hanafi9/sb1-9dzehn3x/README.md

# sb1-9dzehn3x

[Edit in StackBlitz next generation editor ⚡️](https://stackblitz.com/~/github.com/hanafi9/sb1-9dzehn3x)
