hanafi9/sb1-9dzehn3x/machine/printer.cfg

[include mainsail.cfg]
# Klipper Configuration - V-Core 3 400x400mm
# Hardware: CAN Bus + BTT EBB42 v1.1 + Cartographer
#
# Corrections appliquées, référencées sur .RatOS_repo_backup/printers/v-core-3/
# Les lignes modifiées portent un commentaire « CORRIGÉ ».
#
# ÉTAT 2026-09-03 — machine opérationnelle : les 3 vis Z tournent, Z_TILT
#   converge, le bed mesh adaptatif fonctionne.
#   Extrudeur   : HGX Lite (réducteur 9.5:1) — rotation_distance 5.56 calibré
#   PEI         : 400x400 (remplace l'ancien 350x350)
#   Plateau     : coussin 400x400, 230 V AC 1400 W piloté par SSR
#   Capteur SFS : include commenté (capteur muet, voir ligne [include] plus bas)
[include macros-utiles.cfg]
[include resonance-macros.cfg]
# Capteur SFS désactivé le 2026-09-03 : QUERY_FILAMENT_SENSOR répond
# « filament not detected » en permanence (aucune impulsion reçue) et il
# mettait l'impression en PAUSE juste après la ligne de purge.
# ⚠️ Un capteur de filament Klipper est ACTIF PAR DÉFAUT : commenter le
#    SET_FILAMENT_SENSOR ENABLE=1 dans START_PRINT ne suffisait pas.
# Pour le réparer : tourner la roue du SFS et regarder sa LED — si elle
#    clignote c'est le fil signal (PB7), sinon c'est l'alimentation (VS/5V).
#[include filament-sensor.cfg]
[include ai-detection.cfg]
[include leds.cfg]
[include led-effects.cfg] 


#############################################################################################################
### PRINTER CONFIGURATION
#############################################################################################################

[printer]
kinematics: corexy
max_velocity: 300                # CORRIGÉ — était 500
max_accel: 3000                  # CORRIGÉ — était 10000 (profil performance RatOS = 15000,
                                 #           interdit sans refroidissement actif des drivers)
minimum_cruise_ratio: 0.5        # CORRIGÉ — absent ; RatOS le fixe dans ses deux profils
max_z_velocity: 15
max_z_accel: 30                  # CORRIGÉ — était 300, soit 2× le profil performance (150)
                                 #           et 10× le profil basic (30). Cause du grognement
                                 #           des moteurs Z au départ de chaque mouvement.
square_corner_velocity: 5.0

#############################################################################################################
### CANBUS U2C ADAPTER
#############################################################################################################
# Le U2C est un pont USB↔CAN : il crée l'interface can0, il ne pilote rien.
# Le déclarer en [mcu] ajoute un nœud qui doit répondre au démarrage, pour rien.

#[mcu u2c]
#canbus_uuid: 6092d36469e1

#############################################################################################################
### CONTROL BOARD - MAIN MCU
#############################################################################################################

[mcu]
serial: /dev/serial/by-id/usb-Klipper_stm32f446xx_260035000251313133353932-if00
restart_method: command

#############################################################################################################
### TOOLHEAD - BTT EBB42 v1.1
#############################################################################################################

[mcu toolhead]
canbus_interface: can0
canbus_uuid: e3be9642b024

#############################################################################################################
### STEPPER MOTORS
#############################################################################################################
# Câblage réel de cette machine (l'extrudeur étant sur l'EBB42, MOTOR2 est
# libre et les trois Z sont décalés d'un cran par rapport au plan RatOS) :
#   MOTOR0 = X   MOTOR1 = Y
#   MOTOR2 = stepper_z   → vis ARRIÈRE
#   MOTOR3 = stepper_z1  → vis AVANT-GAUCHE
#   MOTOR5 = stepper_z2  → vis AVANT-DROITE   (MOTOR4 abandonné)

[stepper_x]
step_pin: PF13
dir_pin: PF12
enable_pin: !PF14
microsteps: 64
rotation_distance: 40
endstop_pin: ^toolhead:PB6
position_endstop: 0
position_max: 400
position_min: -5
homing_speed: 50
homing_retract_dist: 5

[tmc2209 stepper_x]
uart_pin: PC4
run_current: 0.9                 # CORRIGÉ — était 1.2, le plafond continu d'un TMC2209
                                 #           avec shunts 0,110 Ω. À remplacer par la valeur
                                 #           de .RatOS_repo_backup/printers/v-core-3/v-core-3.cfg
sense_resistor: 0.110
stealthchop_threshold: 0
                                 # CORRIGÉ — diag_pin et driver_SGTHRS retirés : résidus de
                                 #           l'époque sensorless, l'endstop X est le contact
                                 #           physique sur l'EBB42.

[stepper_y]
step_pin: PG0
dir_pin: PG1
enable_pin: !PF15
microsteps: 64
rotation_distance: 40
endstop_pin: ^!PG9
position_endstop: 400
position_max: 400
homing_speed: 50
homing_retract_dist: 5

[tmc2209 stepper_y]
uart_pin: PD11
run_current: 0.9                 # CORRIGÉ — était 1.2
sense_resistor: 0.110
stealthchop_threshold: 0

# ── Z : vis ARRIÈRE ────────────────────────────────────────────────────
[stepper_z]
homing_retract_dist: 0
step_pin: PF11
dir_pin: !PG3                    # CORRIGÉ — inversé : un DISTANCE positif doit FAIRE
                                 #           DESCENDRE le plateau (convention Klipper)
enable_pin: !PG5
microsteps: 64
rotation_distance: 4
endstop_pin: probe:z_virtual_endstop
position_max: 400
position_min: -5
homing_speed: 10

[tmc2209 stepper_z]
uart_pin: PC6
run_current: 0.8
sense_resistor: 0.110
stealthchop_threshold: 0

# ── Z1 : vis AVANT-GAUCHE, sur MOTOR6 ──────────────────────────────────
# Déplacé de MOTOR3 (PG4/PC1/PA0, uart PC7) vers MOTOR6 : MOTOR3 ne
# délivrait aucun courant (moteur libre à la main), prouvé côté carte par
# échange des câbles. MOTOR6 est un slot neuf, jamais utilisé.
[stepper_z1]
step_pin: PE2
dir_pin: !PE3                    # ! provisoire — sens à confirmer par FORCE_MOVE
enable_pin: !PD4
microsteps: 64
rotation_distance: 4

[tmc2209 stepper_z1]
uart_pin: PE1
run_current: 0.8
sense_resistor: 0.110
stealthchop_threshold: 0

# ── Z2 : vis AVANT-DROITE, sur MOTOR7 ──────────────────────────────────
# Déplacé de MOTOR5 (PC13/PF0/PF1, uart PE4) vers MOTOR7 : MOTOR5 alimentait
# le moteur mais ne le faisait pas tourner. MOTOR7 est un slot neuf.
# (MOTOR4 avait déjà été abandonné auparavant.)
[stepper_z2]
step_pin: PE6
dir_pin: !PA14                   # ! provisoire — sens à confirmer par FORCE_MOVE
enable_pin: !PE0
microsteps: 64
rotation_distance: 4

[tmc2209 stepper_z2]
uart_pin: PD3
run_current: 0.8
sense_resistor: 0.110
stealthchop_threshold: 0

#############################################################################################################
### Z TILT — mise à plat du plateau sur les trois vis
#############################################################################################################
# Coordonnées reprises de .RatOS_repo_backup/printers/v-core-3/400.cfg.
# RatOS y documente son propre ordre : stepper_z = gauche (0,0),
# z1 = arrière (200,400), z2 = droite (400,0). Le câblage de cette machine
# étant différent, les mêmes coordonnées sont réordonnées : la Nème ligne
# décrit la vis entraînée par le Nème stepper.
#
# ⚠️ NE PAS lancer Z_TILT_ADJUST avant que les trois vis tournent ET que le
#    plateau soit mis à plat à la main.

[z_tilt]
z_positions:
    200,400                      # stepper_z  → moteur ARRIÈRE
    0,0                          # stepper_z1 → moteur AVANT-GAUCHE
    400,0                        # stepper_z2 → moteur AVANT-DROITE
points:
    40,40                        # vis AVANT-GAUCHE (0,0)
    200,370                      # vis ARRIÈRE (200,400) — sonde à y=370 donc tête à
                                 # y=348,9 avec l'offset Cartographer +21,1 : dans la course
    370,40                       # vis AVANT-DROITE (400,0)
horizontal_move_z: 20
speed: 300
retries: 10
retry_tolerance: 0.02

#############################################################################################################
### HEATER BED
#############################################################################################################

# Coussin 400x400 — 230 V AC 1400 W piloté par SSR (posé le 2026-09-03).
# La carte ne commute que la commande du SSR : aucun courant fort sur l'Octopus.
#
# pwm_cycle_time — INDISPENSABLE avec un SSR secteur. Un SSR à détection de
#   zéro ne peut commuter qu'aux passages par zéro du 50 Hz, soit toutes les
#   10 ms. Le défaut Klipper (0,100 s) le hache de façon erratique : régulation
#   instable et usure prématurée du SSR. 0,3 s = plusieurs alternances par
#   cycle, commutation propre.
# max_power — 1400 W sur 1600 cm² = 0,875 W/cm², c'est très violent : à pleine
#   puissance le plateau dépasse largement la consigne avant de redescendre.
#   Bridé à 60 % il chauffe encore très vite, sans overshoot.
[heater_bed]
heater_pin: PA1
sensor_type: Generic 3950        # = NTC 100K B3950 : correspond à la sonde du coussin
sensor_pin: PF3
control: pid
pid_kp: 54.027                   # ⚠️ VALEURS DE L'ANCIEN COUSSIN — à recalibrer :
pid_ki: 0.770                    #    PID_CALIBRATE HEATER=heater_bed TARGET=80
pid_kd: 948.182                  #    puis SAVE_CONFIG
min_temp: 0
max_temp: 120
max_power: 0.6
pwm_cycle_time: 0.3

#############################################################################################################
### TEMPERATURE SENSORS
#############################################################################################################

[temperature_sensor MainBoard]
sensor_type: temperature_mcu
sensor_mcu: mcu
min_temp: 0
max_temp: 100

[temperature_sensor Toolhead]
sensor_type: temperature_mcu
sensor_mcu: toolhead
min_temp: 0
max_temp: 100

# Thermistor 100k NTC B3950 dans le caisson. La resistance de tirage par
# defaut de Klipper (4700 ohms) est la bonne sur Octopus, inutile de la
# declarer.
#
# ⚠️ Il doit pendre DANS L'AIR LIBRE, a mi-hauteur, loin du plateau et de
#    toute ventilation. Pose dans le bac electronique ou dans un courant
#    d'air, il mesure l'ambiant et non le caisson.
[temperature_sensor Chamber]
sensor_type: Generic 3950
sensor_pin: PF4
min_temp: 0
max_temp: 100
gcode_id: chamber

#############################################################################################################
### CARTOGRAPHER PROBE
#############################################################################################################

# Module scanner.py (et non l'ancien cartographer.py) : c'est le module
# maintenu, écrit pour la nouvelle API « probe session » de Klipper (résultats
# avec .bed_z). cartographer.py renvoyait des listes et plantait au premier
# G28 Z / Z_TILT_ADJUST sur ce Klipper récent. Voir DEPANNAGE panne 7.
# Gabarit officiel : cartographer-klipper/scripts/setup.py.

[mcu scanner]
canbus_uuid: 4973681e12df

[scanner]
mcu: scanner
x_offset: 0
y_offset: 21.1
backlash_comp: 0.5
sensor: cartographer
sensor_alt: carto
mesh_runs: 2

[temperature_sensor Cartographer_MCU]
sensor_type: temperature_mcu
sensor_mcu: scanner
min_temp: 0
max_temp: 105

#############################################################################################################
### EXTRUDER (EBB42)
#############################################################################################################

[extruder]
step_pin: toolhead:PD0
dir_pin: toolhead:PD1
enable_pin: !toolhead:PD2
microsteps: 16
rotation_distance: 5.56    # HGX Lite
nozzle_diameter: 0.400
filament_diameter: 1.750
heater_pin: toolhead:PB13
sensor_type: PT1000
sensor_pin: toolhead:PA3
# Si la température de buse est décalée au repos, c'est le pullup : l'EBB42
# commute une résistance de précision par cavalier ou DIP. Déclarer alors
# pullup_resistor: <valeur du montage> (Klipper suppose 4700 par défaut).
min_temp: 0
max_temp: 300
max_extrude_only_distance: 500
max_extrude_cross_section: 5
pressure_advance: 0.05
pressure_advance_smooth_time: 0.040

[tmc2209 extruder]
uart_pin: toolhead:PA15
run_current: 0.650
sense_resistor: 0.110
stealthchop_threshold: 0

#############################################################################################################
### HOTEND FAN & PART COOLING
#############################################################################################################

[heater_fan hotend_fan]
pin: toolhead:PA1
heater: extruder
heater_temp: 50.0

[fan]
pin: toolhead:PA0

#############################################################################################################
### VENTILATEUR DE CARTE
#############################################################################################################
# CNC FAN2. Sans cette section le ventilateur ne démarrait jamais, alors que
# RatOS conditionne tout profil d'accélération élevé à un refroidissement
# actif des drivers.

[controller_fan board_fan]
pin: PD12
kick_start_time: 0.5             # CORRIGÉ — ajouté : démarrage franc du ventilateur
fan_speed: 1.0
idle_timeout: 60
stepper: stepper_x, stepper_y, stepper_z, stepper_z1, stepper_z2
heater: heater_bed

#############################################################################################################
### ADXL345 ACCELEROMETER
#############################################################################################################

[adxl345]
cs_pin: toolhead:PB12
spi_software_sclk_pin: toolhead:PB10
spi_software_mosi_pin: toolhead:PB11
spi_software_miso_pin: toolhead:PB2
axes_map: x,y,z

[resonance_tester]
accel_chip: adxl345
probe_points: 200, 200, 20

#############################################################################################################
### BED MESH
#############################################################################################################

[bed_mesh]
zero_reference_position: 200, 200
mesh_min: 30, 30                 # PEI 400x400 depuis le 2026-09-03 (avant : 65,65).
mesh_max: 370, 370               #   Sonde à y=370 → tête à y=348,9 : OK. À y=30 → tête à 8,9 : OK.
speed: 200
horizontal_move_z: 2             # DOIT rester dans la plage du coil (model_range 0,1-5 mm).
                                 #   À 5 mm le coil sort de sa plage sur les zones basses
                                 #   → Z aberrants + « Mesh extends outside of fade range ».
probe_count: 15, 15
algorithm: bicubic
fade_start: 1
fade_end: 10
fade_target: 0

#############################################################################################################
### COMPENSATION DE VRILLAGE D'AXE
#############################################################################################################
# La sonde Cartographer n'est pas sous la buse : y_offset = 21,1 mm. Si la tete
# bascule du nez (rotation autour de X) a un endroit du plateau, la sonde ne
# mesure plus la hauteur que verra la buse. L'erreur vaut 21,1 x tan(angle) :
#
#     0,1 deg -> 0,037 mm      0,3 deg -> 0,110 mm      0,5 deg -> 0,184 mm
#
# Un demi-degre — invisible a l'oeil, banal sur un portique de 400 mm portant
# une tete en porte-a-faux — suffit a produire toute l'amplitude du bed_mesh.
# Et ce basculement varie avec la position : le portique X vrille legerement
# selon ou est la tete, les deux rails Y ne sont jamais parfaitement coplanaires.
#
# x_offset vaut 0, donc un roulis (rotation autour de Y) ne produit aucune
# erreur : 0 x tan(angle) = 0. Seul le basculement compte, mais il compte double
# a cause des 21,1 mm.
#
# ── CALIBRATION ─────────────────────────────────────────────────────────────
# Plateau chaud (meme temperature qu'en impression), puis :
#
#     AXIS_TWIST_COMPENSATION_CALIBRATE AXIS=X
#     AXIS_TWIST_COMPENSATION_CALIBRATE AXIS=Y
#     SAVE_CONFIG
#
# A chaque point Klipper descend la buse et demande de regler au papier, comme
# un Z_ENDSTOP_CALIBRATE : le papier doit juste frotter. C'est la mesure de la
# BUSE qui sert de reference, et l'ecart avec ce qu'a lu la sonde donne la
# correction. Compter une dizaine de minutes pour les deux axes.
#
# Refaire apres tout demontage du portique, de la tete ou de la sonde.
#
# ⚠️ Faire la calibration AVANT un BED_MESH_CALIBRATE, jamais l'inverse : le
#    maillage doit etre construit sur des mesures deja corrigees.

[axis_twist_compensation]
horizontal_move_z: 2             # Comme pour bed_mesh : le coil Cartographer a
                                 #   une plage de 0,1 a 5 mm. La valeur par
                                 #   defaut de Klipper (5) le met en limite.
speed: 50

# Coordonnees de la BUSE (pas de la sonde). Avec y_offset 21,1 la sonde ira
# 21,1 mm plus loin en Y : nozzle_y 200 -> sonde a 221,1, dans le plateau.
calibrate_start_x: 30
calibrate_end_x: 370
calibrate_y: 200

# En Y la buse s'arrete a 340 : la sonde serait sinon a 340 + 21,1 = 361,1,
# puis au-dela du plateau aux points suivants.
calibrate_start_y: 30
calibrate_end_y: 340
calibrate_x: 200

#############################################################################################################
### HOMING
#############################################################################################################

[safe_z_home]
home_xy_position: 200, 200
speed: 100
z_hop: 10
z_hop_speed: 15

[force_move]
enable_force_move: True
[exclude_object]
[gcode_macro _ON_LAYER_CHANGE]
gcode:
    {% set layer = params.LAYER|default(0)|int %}
    SET_PRINT_STATS_INFO CURRENT_LAYER={layer}
    # hook par couche : le timelapse ou d'autres actions peuvent se greffer ici
#############################################################################################################
### CHAMBER & LED CONTROL
#############################################################################################################

# Un [heater_fan] ne se commande pas a la main : Klipper refuse de l'eteindre
# tant que la buse est chaude, et SET_FAN_SPEED renvoie une erreur dessus.
# Cette macro fait donc le seul test possible — chauffer juste au-dessus du
# seuil et laisser le ventilateur demarrer tout seul.
[gcode_macro TEST_VENTILO_BUSE]
description: Teste le ventilateur de dissipateur (hotend_fan)
gcode:
    {% set seuil = printer.configfile.settings['heater_fan hotend_fan'].heater_temp|float %}
    M117 Chauffe — demarrage attendu a {seuil} C
    M104 S{seuil + 10}
    TEMPERATURE_WAIT SENSOR=extruder MINIMUM={seuil + 5}
    M117 Ventilateur en marche — ecoute et touche le flux
    G4 P10000
    M104 S0
    M117 Fin du test — il tournera jusqu'a redescendre sous {seuil} C

[fan_generic chamber_fan]
# Ventilateur 12 V branche sur FAN1. Etait declare sur PA8 (FAN0), un
# connecteur vide : Klipper commandait dans le vide et rien ne tournait.
#
# ⚠️ VENTILATEUR 12 V — le cavalier de tension de FAN1 doit etre sur 12 V.
#    Sur 24 V il grille des la premiere commande.
pin: PE5                         # FAN1
max_power: 1.0
shutdown_speed: 0
kick_start_time: 0.5

[gcode_macro CHAMBER_FAN_ON]
gcode:
    {% set speed = params.SPEED|default(1.0)|float %}
    SET_FAN_SPEED FAN=chamber_fan SPEED={speed}

[gcode_macro CHAMBER_FAN_OFF]
gcode:
    SET_FAN_SPEED FAN=chamber_fan SPEED=0

# Ruban BTF-Lighting FCOB SPI RGB, IC WS2811, 24 V.
# C'est de l'ADRESSABLE, pas un COB a gradation PWM : le fil « signal » porte
# des donnees, pas un rapport cyclique. D'ou [neopixel] et non [output_pin].
#
# ⚠️ color_order RGB — le WS2811 attend du RGB, la ou le WS2812 de
#    chamber_leds attend du GRB. Se tromper inverse rouge et vert.
#
# ⚠️ chain_count = nombre de SEGMENTS, pas de LED. En 24 V un IC WS2811
#    commande un groupe de LED (souvent 6) : un segment = un trait de coupe
#    sur le ruban. Compter les traits sur la longueur installee.
#    En cas de doute, mettre large : les donnees en trop ne sont recues par
#    personne, c'est sans consequence. On affine ensuite.
#
# ⚠️ ALIMENTATION : le 24 V et le GND viennent de l'alimentation (ou du + et -
#    d'un port FAN), JAMAIS du connecteur Neopixel de la carte, qui ne
#    delivre que du 5 V. Seul le fil de donnees va sur PB10.
#    La masse doit etre commune avec la carte, sinon le signal n'a pas de
#    reference et le ruban fait n'importe quoi.
#
# Si des scintillements ou des couleurs qui sautent apparaissent : Klipper
# sort la donnee en 3,3 V et le WS2811 en attend plutot 5. Ajouter un
# adaptateur de niveau (74AHCT125). Ce n'est pas un probleme de config.
# LED RGB placee face a la buse, sur le port RGB de l'EBB42.
# ⚠️ A VERIFIER : pin et chain_count. PD3 est la seule broche libre de
#    l'EBB42 et c'est son connecteur RGB, mais confirme-le. chain_count est
#    le nombre de LED : 1 pour une seule, 3 / 6 / 12 pour un anneau.
[neopixel buse_led]
pin: toolhead:PD3
chain_count: 1
color_order: GRB
initial_RED: 0
initial_GREEN: 0
initial_BLUE: 0

[neopixel cob_led]
pin: PB0                         # connecteur Neopixel — sortie logique sure
chain_count: 47                  # segments comptes sur le ruban installe
                                 #   (1 IC WS2811 = 1 segment = 1 trait de coupe)
color_order: RGB
initial_RED: 0
initial_GREEN: 0
initial_BLUE: 0

# ⚠️ EN PAUSE — le COB occupe PB0. Deux sections [neopixel] ne peuvent pas
#    partager une broche : Klipper refuse de demarrer.
#
#    Pour remettre les deux rubans en service, il faut une seconde broche
#    LOGIQUE libre (verifiee au brochage de la carte, pas une sortie FAN),
#    puis decommenter ce bloc avec cette broche, et rendre a _LED_VARS son
#    variable_neopixel: 'chamber_leds'.
#
#    A noter avant de le rebrancher : 24 WS2812 en blanc plein tirent environ
#    1,4 A sur le rail 5 V de la carte, qui alimente aussi le microcontroleur.
#    Et initial_*: 1.0 les allumait en blanc plein des la mise sous tension.
#    C'est une cause connue de redemarrages inexpliques. Si ce ruban revient,
#    mettre initial_* a 0.
#
# [neopixel chamber_leds]
# pin: <broche logique libre>
# chain_count: 24
# color_order: GRB
# initial_RED: 0
# initial_GREEN: 0
# initial_BLUE: 0

# Ces trois macros nommaient le ruban en dur (chamber_leds). Quand ce ruban a
# ete mis en pause, _USER_START_PRINT_BEFORE_HOMING appelait toujours LED_ON :
# Klipper interrompait START_PRINT sur « not valid for LED », la chauffe
# n'avait jamais lieu, et le G-code suivant echouait sur « extruder not hot
# enough ». Elles passent desormais par les primitives de leds.cfg, qui lisent
# le nom du ruban dans _LED_VARS : une seule source de verite.
[gcode_macro LED_ON]
gcode:
    LUMIERE

[gcode_macro LED_OFF]
gcode:
    LUMIERE_OFF

[gcode_macro LED_DIM]
gcode:
    LUMIERE V=0.2

#############################################################################################################
### USER OVERRIDES & CUSTOM SETTINGS
#############################################################################################################

# Porte-variable : START_PRINT y depose la vitesse d'extraction choisie, ce
# crochet la relit. Les crochets _USER_* ne recoivent pas les parametres de
# START_PRINT, d'ou ce detour.
[gcode_macro _PRINT_VARS]
variable_chamber_fan: 0.5
# Y maximal que la BUSE peut atteindre sans toucher le chassis.
#
# Ce n'est PAS position_max : le homing va bien jusqu'a 400, mais la vis Z
# arriere a ete changee et depasse davantage. La tete cogne donc avant
# d'arriver au bout de sa course theorique.
#
# ⚠️ A MESURER : G28, puis G1 Z80, puis monter en Y par pas de 5 mm jusqu'a
#    frotter. Retirer 5 mm de marge et reporter ici.
#    355 est une valeur prudente de depart, pas une mesure.
#
# Les parkings de START_PRINT et END_PRINT s'y referent. Les points de
# z_tilt et de bed_mesh n'en ont pas besoin : la sonde etant 21,1 mm devant
# la buse, un palpage a Y=370 ne met la tete qu'a 348,9.
variable_y_max_sur: 355
gcode:
    # Section porte-variables, rien a executer

[gcode_macro _USER_START_PRINT_BEFORE_HOMING]
gcode:
    LED_ON
    CHAMBER_FAN_ON SPEED={printer["gcode_macro _PRINT_VARS"].chamber_fan}

[gcode_macro _USER_START_PRINT_AFTER_HEATING_BED]
gcode:
    # Custom commands after bed heating

[gcode_macro _USER_START_PRINT_BEFORE_HEATING_EXTRUDER]
gcode:
    # Custom commands before extruder heating

[gcode_macro _USER_START_PRINT_PARK]
gcode:
    # Custom park position

[gcode_macro _USER_END_PRINT_AFTER_HEATERS_OFF]
gcode:
    CHAMBER_FAN_ON SPEED=1.0
    LED_DIM

[gcode_macro _USER_END_PRINT_PARK]
gcode:
    # Custom park position for end print

#############################################################################################################
### MACROS D'IMPRESSION
#############################################################################################################

# ═══════════════════════════════════════════════════════════════════════
#  CHAUFFE DU CAISSON — par le plateau, sans chauffage dedie
#
#  Pas besoin d'un radiateur de caisson pour l'ABS ou l'ASA : un plateau de
#  1400 W dans un volume ferme y suffit largement. Ce qui manque d'habitude,
#  ce n'est pas la puissance, c'est le TEMPS et l'etancheite.
#
#  La macro attend la temperature REELLE du caisson au lieu d'une duree
#  fixe : selon la temperature de la piece et ce qui est ferme, la montee
#  prend de dix minutes a une demi-heure.
#
#  ⚠️ L'extraction doit etre coupee, sinon on evacue ce qu'on produit.
# ═══════════════════════════════════════════════════════════════════════

[gcode_macro CHAUFFE_CAISSON]
description: Chauffe le caisson par le plateau. Params: BED, CHAMBRE
gcode:
    {% set bed     = params.BED|default(110)|float %}
    {% set cible   = params.CHAMBRE|default(45)|float %}
    {% set actuel  = printer["temperature_sensor Chamber"].temperature|float %}

    CHAMBER_FAN_ON SPEED=0
    M140 S{bed}

    {% if actuel >= cible %}
        M117 Caisson deja a {actuel|round(1)} C
    {% else %}
        M117 Caisson {actuel|round(1)} -> {cible} C, patience...
        TEMPERATURE_WAIT SENSOR="temperature_sensor Chamber" MINIMUM={cible}
        M117 Caisson a {cible} C — pret
    {% endif %}

[gcode_macro START_PRINT]
gcode:
    {% set BED = params.BED_TEMP|default(60)|float %}
    {% set HOTEND = params.EXTRUDER_TEMP|default(230)|float %}
    # Trempe thermique avant le maillage. M190 rend la main des que le
    # thermistor lit la consigne — or il est colle sous la plaque a un endroit
    # precis. A cet instant une plaque de 400x400 est chaude au centre et encore
    # tiede sur les bords : elle continue de se deformer pendant plusieurs
    # minutes. Mailler la maintenant, c'est figer une forme transitoire.
    # G28 + Z_TILT_ADJUST en absorbent deja 1 a 2 min, d'ou les 240 s restantes.
    # Impressions a la chaine (plateau deja chaud) : passer SOAK=0.
    {% set SOAK = params.SOAK|default(240)|int %}
    # Extraction du caisson. 0.5 convient au PLA et au PETG, qui n'aiment pas
    # un caisson chaud. Pour l'ABS et l'ASA il faut 0 : la chaleur du caisson
    # est precisement ce qui empeche le retrait et le decollement.
    #   START_PRINT ... CHAMBER_FAN=0      ABS / ASA
    #   START_PRINT ... CHAMBER_FAN=0.5    PLA / PETG (defaut)
    {% set CHAMBER_FAN = params.CHAMBER_FAN|default(0.5)|float %}
    SET_GCODE_VARIABLE MACRO=_PRINT_VARS VARIABLE=chamber_fan VALUE={CHAMBER_FAN}
    CLEAR_PAUSE
    G90
    M83
    _USER_START_PRINT_BEFORE_HOMING
    M140 S{BED}
    STATUS_HEATING_BED
    M190 S{BED}
    _USER_START_PRINT_AFTER_HEATING_BED
    STATUS_HOMING
    G28
    STATUS_LEVELING
    Z_TILT_ADJUST
    G28 Z
    # Fin de la trempe : le portique a deja travaille pendant G28 + Z_TILT.
    {% if SOAK > 0 %}
        M117 Trempe thermique {SOAK}s — la plaque s'homogeneise
        G4 P{SOAK * 1000}
    {% endif %}
    STATUS_MESHING
    BED_MESH_CALIBRATE ADAPTIVE=1
    _USER_START_PRINT_BEFORE_HEATING_EXTRUDER
    # --- Présente la buse : lit BAS Z60 + centre X200 arrière (brosse pendant la chauffe) ---
    G90
    G1 Z60 F1500
    G1 X200 Y{printer["gcode_macro _PRINT_VARS"].y_max_sur} F6000
    M117 Nettoie la buse pendant la chauffe
    STATUS_HEATING_NOZZLE
    M109 S{HOTEND}
    # --- Ligne de purge SUR le PEI ---
    # Apres la chauffe la buse s'est videe (coulure + retraction) : sans
    # amorcage prealable, les 20-40 premiers mm de la ligne sortent a vide.
    # Le G1 E8 sur place remplit la chambre de fusion AVANT de tracer.
    G1 Z5 F600
    G1 X60 Y50 F6000
    G1 Z0.3 F600
    G92 E0
    G1 E8 F180                   # amorcage sur place (monter a E10-E12 si la
                                 #   ligne demarre encore a vide, baisser a E5
                                 #   si un pate se forme au depart)
    G92 E0
    G1 X220 Y50 E15 F1200        # 1re ligne
    G1 Y50.7 F6000               # decalage d'une largeur de trait
    G1 X60 Y50.7 E12 F1800       # 2e ligne : essuie la buse, confirme le debit
    G1 E-0.5 F1800               # petite retraction anti-fil vers la piece
    G1 Z2 F600
    G92 E0
  #  SET_FILAMENT_SENSOR SENSOR=SFS ENABLE=1
    STATUS_PRINTING
    M117 Impression...
  

[gcode_macro END_PRINT]
gcode:
    M400
  #  SET_FILAMENT_SENSOR SENSOR=SFS ENABLE=0
    G91
    G1 E-3 F1800
    G1 Z10 F600
    G90
    # Essuyage pendant que la buse est ENCORE CHAUDE. TEMP=0 saute la chauffe :
    # elle est deja a temperature d'impression, lui demander 180 la ferait
    # attendre le refroidissement.
    NOZZLE_CLEAN TEMP=0
    TURN_OFF_HEATERS
    _USER_END_PRINT_AFTER_HEATERS_OFF
    M107
    _USER_END_PRINT_PARK
    G1 Z{printer.toolhead.position.z + 30} F1500
    # Meme limite qu'au parking de chauffe : la vis Z arriere empeche
    # d'aller au bout de la course en Y.
    G1 X200 Y{printer["gcode_macro _PRINT_VARS"].y_max_sur} F6000
    M84
    STATUS_DONE

# ⚠️ Le [bed_mesh default] ci-dessous date de l'ANCIEN PEI (min_x/min_y 65,
#    max 335). Après le changement de PEI et de coussin, relancer :
#        BED_MESH_CALIBRATE
#        SAVE_CONFIG
#    (le mesh adaptatif de START_PRINT en recalcule un par impression, mais
#     le profil « default » stocké ici reste périmé tant qu'il n'est pas refait)

#*# <---------------------- SAVE_CONFIG ---------------------->
#*# DO NOT EDIT THIS BLOCK OR BELOW. The contents are auto-generated.
#*#
#*# [extruder]
#*# control = pid
#*# pid_kp = 19.667
#*# pid_ki = 1.237
#*# pid_kd = 78.178
#*#
#*# [scanner model default]
#*# model_coef = 1.2808871901975378,
#*# 	  1.7209825327620678,
#*# 	  0.7988929226619492,
#*# 	  0.37677930273471877,
#*# 	  0.43442341047278077,
#*# 	  0.4743340381671791,
#*# 	  -0.32455652314672645,
#*# 	  -0.4750695827220033,
#*# 	  0.3608331597583763,
#*# 	  0.3541083655049169
#*# model_domain = 3.1331855588576364e-07,3.342056470653336e-07
#*# model_range = 0.100000,5.000000
#*# model_temp = 34.989814
#*# model_offset = 0.37500
#*# model_mode = scan
#*# model_fw_version = CARTOGRAPHER 5.1.0
#*#
#*# [input_shaper]
#*# shaper_type_x = mzv
#*# shaper_freq_x = 60.2
#*# shaper_type_y = 2hump_ei
#*# shaper_freq_y = 56.0
#*#
#*# [bed_mesh default]
#*# version = 1
#*# points =
#*# 	-0.011656, -0.004038, -0.004530, -0.007685, -0.005218, -0.000628, 0.002770, 0.006611, 0.004844, 0.006698, 0.004188, 0.008051, 0.018622, 0.019528, 0.004355
#*# 	-0.034949, -0.025298, -0.018713, -0.012296, -0.009057, -0.001922, 0.005472, 0.008777, 0.009425, 0.004036, 0.003225, 0.009471, 0.016991, 0.016651, 0.002288
#*# 	-0.054010, -0.038755, -0.019062, -0.008623, -0.002380, 0.010861, 0.018883, 0.016331, 0.013109, 0.006278, 0.004306, 0.010584, 0.020137, 0.021346, 0.008174
#*# 	-0.086748, -0.063143, -0.039028, -0.023672, -0.008977, 0.004863, 0.010320, 0.013237, 0.013267, 0.006691, -0.003935, -0.006176, 0.002889, 0.008994, -0.002014
#*# 	-0.105302, -0.077241, -0.046375, -0.023295, -0.006906, 0.007971, 0.014609, 0.027023, 0.027513, 0.017112, 0.006369, 0.001696, 0.005083, 0.010185, 0.002550
#*# 	-0.116873, -0.083410, -0.049813, -0.023900, -0.005526, 0.010114, 0.018618, 0.028976, 0.030646, 0.019056, 0.006145, 0.000968, 0.001098, 0.003663, -0.001867
#*# 	-0.146294, -0.104917, -0.069267, -0.044500, -0.024379, -0.005246, 0.006842, 0.010379, 0.015347, 0.007962, -0.004102, -0.007867, -0.007128, -0.007116, -0.016508
#*# 	-0.173374, -0.123093, -0.082517, -0.055956, -0.035549, -0.017073, -0.003845, 0.000000, 0.000619, -0.000718, -0.006789, -0.011161, -0.009034, -0.008637, -0.017390
#*# 	-0.195622, -0.143854, -0.100289, -0.069182, -0.042634, -0.018342, -0.005851, -0.003680, 0.002411, 0.000455, -0.003967, -0.006844, -0.001730, -0.001703, -0.011913
#*# 	-0.209013, -0.154433, -0.112117, -0.079463, -0.048860, -0.022980, -0.011489, -0.004198, 0.002295, -0.001210, -0.001622, -0.000968, 0.003704, 0.000536, -0.009194
#*# 	-0.221083, -0.171739, -0.130137, -0.087634, -0.054491, -0.028939, -0.012583, -0.005236, 0.002930, -0.001588, -0.000995, 0.001303, 0.004166, 0.001283, -0.007391
#*# 	-0.250117, -0.196022, -0.149177, -0.108476, -0.073211, -0.043312, -0.026563, -0.014468, -0.004788, -0.004014, -0.001296, 0.005860, 0.005863, 0.001892, -0.008051
#*# 	-0.277323, -0.219950, -0.173065, -0.134295, -0.097106, -0.066059, -0.044174, -0.029246, -0.014747, -0.008263, -0.004309, 0.003790, 0.005876, 0.001976, -0.008403
#*# 	-0.292230, -0.235808, -0.190167, -0.147880, -0.107610, -0.071285, -0.047724, -0.026591, -0.008639, 0.002826, 0.006107, 0.009643, 0.014709, 0.011969, 0.000146
#*# 	-0.326171, -0.264305, -0.213480, -0.169673, -0.125552, -0.090715, -0.056425, -0.035005, -0.012295, -0.003208, -0.002202, -0.002780, 0.005906, 0.002492, -0.003924
#*# x_count = 15
#*# y_count = 15
#*# mesh_x_pps = 2
#*# mesh_y_pps = 2
#*# algo = bicubic
#*# tension = 0.2
#*# min_x = 65.0
#*# max_x = 335.0
#*# min_y = 65.0
#*# max_y = 335.0
