hanafi9/sb1-9dzehn3x/machine/led-effects.cfg

# ═══════════════════════════════════════════════════════════════════
#  led-effects.cfg — animations du ruban FCOB WS2811
#
#  Necessite le module klipper-led_effect (julianschill). Verifier :
#      ls -l ~/klipper/klippy/extras/led_effect.py
#  S'il manque :
#      ~/klipper-led_effect/install-led_effect.sh
#
#  Pourquoi ce module plutot que des macros : il anime en tache de fond, a
#  frame_rate images par seconde, independamment du gestionnaire de commandes.
#  M190 et M109 gardent ce gestionnaire jusqu'a la consigne — une animation
#  ecrite en delayed_gcode reste donc figee pendant toute la chauffe, ce qui
#  est precisement le moment ou l'on voudrait la voir.
#
#  ── SYNTAXE D'UNE COUCHE ──────────────────────────────────────────
#      <effet>  <vitesse>  <parametre>  <fusion>  <palette>
#
#  Le premier nombre est la VITESSE — sauf pour breathing et linearfade, ou
#  c'est une DUREE en secondes : pour ceux-la, un nombre plus grand ralentit.
#
#  Une vitesse NEGATIVE inverse le sens de defilement. Les etapes alternent
#  donc le sens, ce qui rend le passage de l'une a l'autre evident meme si
#  les couleurs se ressemblent :
#      chauffe plateau  ->    homing  <-    z-tilt  ->    maillage  <-
#      chauffe buse     ->
#
#  Une animation lancee TOURNE JUSQU'A CE QU'UNE AUTRE LA REMPLACE. Chaque
#  etape garde donc la sienne jusqu'a la suivante — c'est le comportement
#  par defaut, il n'y a rien a faire pour l'obtenir.
#  Les couches se superposent de BAS en HAUT : la derniere ecrite est au
#  fond. D'ou le `static ... bottom` en dernier, qui sert de fond continu.
#
#  ── COMMANDES ─────────────────────────────────────────────────────
#      SET_LED_EFFECT EFFECT=<nom> REPLACE=1     lance et remplace
#      STOP_LED_EFFECTS                          arrete tout
# ═══════════════════════════════════════════════════════════════════


# ─── Chauffe — fondu de couleur, sans mouvement ────────────────────
# `linearfade` fond la palette DANS LE TEMPS, tout le ruban prenant la meme
# couleur au meme instant : jaune, puis orange, puis rouge, puis retour.
# Aucun defilement, aucune comete — juste la couleur qui evolue.
#
# Le premier parametre est la duree du fondu complet en secondes. Plus court
# pour la buse, qui monte plus vite en temperature.
#
# ⚠️ Le cycle BOUCLE : il ne s'arrete pas au rouge, il repart au jaune. Rien
#    ici ne lit la temperature — la couche `heater` de led_effect le ferait,
#    mais elle a ete essayee trois fois sans succes sur cette installation
#    (syntaxe variable selon les versions ; une couche refusee rend du noir).
#    Pour y revenir un jour :
#        heater  30  0  add  (1.0,1.0,0.0),(1.0,0.0,0.0)
#    avec `heater: heater_bed` (ou `extruder`) au niveau de la section, et un
#    test fait AVEC une consigne active (M140 S80) : sans consigne la couche
#    est eteinte par definition.

[led_effect ef_chauffe_plateau]
leds:
    neopixel:cob_led
autostart: false
frame_rate: 24
layers:
    linearfade  12  0  top  (1.0,1.0,1.0),(0.0,0.8,1.0),(0.0,1.0,0.3),(1.0,1.0,0.0),(1.0,0.45,0.0),(1.0,0.0,0.0)

[led_effect ef_chauffe_buse]
leds:
    neopixel:cob_led
autostart: false
frame_rate: 24
layers:
    linearfade   7  0  top  (1.0,1.0,1.0),(0.0,0.8,1.0),(0.0,1.0,0.3),(1.0,1.0,0.0),(1.0,0.45,0.0),(1.0,0.0,0.0)


# ─── Homing — balayage cyan, rapide et nerveux ─────────────────────

[led_effect ef_homing]
leds:
    neopixel:cob_led
autostart: false
frame_rate: 24
layers:
    chase   -1.6  3  add      (0.0,0.7,1.0),(0.0,0.15,0.3)
    static  0    0  bottom   (0.0,0.02,0.05),(0.0,0.02,0.05)
# ─── Z-tilt — cometes violettes ────────────────────────────────────

[led_effect ef_zilt]
leds:
    neopixel:cob_led
autostart: false
frame_rate: 24
layers:
    comet    1.0  6  add      (0.7,0.0,1.0),(0.15,0.0,0.3)
    static  0    0  bottom   (0.04,0.0,0.06),(0.04,0.0,0.06)
# ─── Bed mesh — vague orange lente ─────────────────────────────────
# `comet` a longue traine plutot que `chase` : le chase decoupe le ruban en
# segments qui s'allument et s'eteignent franchement, ce qui donne un effet
# stroboscopique agressif. La comete a un degrade sur toute sa longueur, donc
# aucune transition brutale — c'est la traine (2e nombre) qui adoucit, pas
# seulement la vitesse.

[led_effect ef_mesh]
leds:
    neopixel:cob_led
autostart: false
frame_rate: 24
layers:
    comet   -0.5  12  add      (1.0,0.28,0.0),(0.3,0.08,0.0)
    static   0    0  bottom   (0.07,0.02,0.0),(0.07,0.02,0.0)
# ⚠️ PALETTES DOUBLEES. Les couches ci-dessous repetent leur couleur au lieu
#    de la citer une fois. Une palette a UNE seule couleur laissait le premier
#    segment sur une teinte parasite (rouge), alors qu'un SET_LED direct sur
#    le meme ruban l'allume correctement — le cablage est donc hors de cause.
#    Citer la couleur deux fois force une interpolation normale sur toute la
#    chaine et evite ce cas limite.


# ─── Impression — BLANC FIXE, volontairement ───────────────────────
# Pas d'animation ici, et c'est un choix : la webcam a besoin d'un
# eclairage constant. Une lumiere qui varie fait pomper l'exposition
# automatique, et le workflow n8n analyse ces images pour detecter les
# anomalies — des variations de luminosite lui donneraient de fausses
# alertes. L'animation sert a signaler ce qui se PREPARE ; une fois que
# ca imprime, on veut juste voir.

[led_effect ef_impression]
leds:
    neopixel:cob_led
autostart: false
frame_rate: 24
layers:
    static  0  0  top  (1.0,1.0,1.0),(1.0,1.0,1.0)


# ─── Pause — orange qui respire ────────────────────────────────────

[led_effect ef_pause]
leds:
    neopixel:cob_led
autostart: false
frame_rate: 24
layers:
    breathing  3  0  top  (1.0,0.35,0.0),(1.0,0.35,0.0)


# ─── Termine — vert qui respire doucement ──────────────────────────

[led_effect ef_fini]
leds:
    neopixel:cob_led
autostart: false
frame_rate: 24
layers:
    breathing  6  0  top  (0.0,1.0,0.15),(0.0,1.0,0.15)


# ─── Erreur — rouge stroboscopique, impossible a rater ─────────────

[led_effect ef_erreur]
leds:
    neopixel:cob_led
autostart: false
frame_rate: 24
layers:
    strobe  1.4  0.4  add      (1.0,0.0,0.0),(1.0,0.0,0.0)
    static  0    0    bottom   (0.15,0.0,0.0),(0.15,0.0,0.0)
# ─── Veille — lueur froide, presque eteinte ────────────────────────

[led_effect ef_veille]
leds:
    neopixel:cob_led
autostart: false
frame_rate: 24
layers:
    breathing  10  0  top  (0.1,0.1,0.15),(0.1,0.1,0.15)


# ═══════════════════════════════════════════════════════════════════
#  TEST — enchaine toutes les animations, 4 s chacune
# ═══════════════════════════════════════════════════════════════════

[gcode_macro EFFETS_TEST]
description: Passe en revue toutes les animations du ruban
gcode:
    {% for nom in ['ef_chauffe_plateau', 'ef_chauffe_buse', 'ef_homing',
                   'ef_zilt', 'ef_mesh', 'ef_impression', 'ef_pause',
                   'ef_fini', 'ef_erreur', 'ef_veille'] %}
        M117 {nom}
        SET_LED_EFFECT EFFECT={nom} REPLACE=1
        G4 P4000
    {% endfor %}
    STOP_LED_EFFECTS
    M117 Fin du test


# ═══════════════════════════════════════════════════════════════════
#  LED DE BUSE — jeu d'effets distinct
#
#  Une seule LED : aucun effet SPATIAL n'est visible. Comete, balayage,
#  barre de progression supposent plusieurs LED en ligne et ne rendent rien
#  ici. Seuls les effets qui jouent sur le TEMPS fonctionnent — linearfade,
#  breathing, blink, strobe. C'est cette contrainte qui rend le jeu de la
#  buse naturellement different de celui du caisson.
#
#  Les STATUS_* lancent les DEUX effets. REPLACE=1 ne coupe que les effets
#  partageant les memes LED, donc caisson et buse coexistent sans se gener.
#
#  Avec un anneau de 3, 6 ou 12 LED, les effets spatiaux redeviendraient
#  possibles : il suffirait d'ajuster chain_count et de reprendre les
#  couches comete / chase du caisson.
# ═══════════════════════════════════════════════════════════════════

[led_effect ef_buse_chauffe_plateau]
leds:
    neopixel:buse_led
autostart: false
frame_rate: 24
layers:
    linearfade  12  0  top  (1.0,1.0,1.0),(0.0,0.8,1.0),(0.0,1.0,0.3),(1.0,1.0,0.0),(1.0,0.45,0.0),(1.0,0.0,0.0)

[led_effect ef_buse_chauffe_buse]
leds:
    neopixel:buse_led
autostart: false
frame_rate: 24
layers:
    linearfade   7  0  top  (1.0,1.0,1.0),(0.0,0.8,1.0),(0.0,1.0,0.3),(1.0,1.0,0.0),(1.0,0.45,0.0),(1.0,0.0,0.0)

# Homing : clignotement cyan franc. La tete cherche ses butees, l'effet est
# volontairement nerveux la ou le caisson fait un balayage.
[led_effect ef_buse_homing]
leds:
    neopixel:buse_led
autostart: false
frame_rate: 24
layers:
    blink  2.5  0.5  top  (0.0,0.7,1.0),(0.0,0.1,0.2)

[led_effect ef_buse_zilt]
leds:
    neopixel:buse_led
autostart: false
frame_rate: 24
layers:
    breathing  2  0  top  (0.7,0.0,1.0),(0.7,0.0,1.0)

[led_effect ef_buse_mesh]
leds:
    neopixel:buse_led
autostart: false
frame_rate: 24
layers:
    breathing  2.5  0  top  (1.0,0.28,0.0),(1.0,0.28,0.0)

[led_effect ef_buse_pause]
leds:
    neopixel:buse_led
autostart: false
frame_rate: 24
layers:
    blink  1.2  0.5  top  (1.0,0.35,0.0),(0.1,0.03,0.0)

[led_effect ef_buse_fini]
leds:
    neopixel:buse_led
autostart: false
frame_rate: 24
layers:
    breathing  4  0  top  (0.0,1.0,0.15),(0.0,1.0,0.15)

[led_effect ef_buse_erreur]
leds:
    neopixel:buse_led
autostart: false
frame_rate: 24
layers:
    strobe  2  0.4  top  (1.0,0.0,0.0),(1.0,0.0,0.0)

[led_effect ef_buse_veille]
leds:
    neopixel:buse_led
autostart: false
frame_rate: 24
layers:
    breathing  10  0  top  (0.1,0.1,0.15),(0.1,0.1,0.15)
