hanafi9/sb1-9dzehn3x/(commit log)

2026-05-27 feat: VCore 3.1 / RatOS v2.1 configurator with probe & bed mesh
    Complete Klipper configuration tool for VCore 3.1 CoreXY printer:
    - Printer settings: size (300/400/500mm), board, extruder, hotend
    - Probe configurator: Beacon, Cartographer, Klicky, Euclid, BL-Touch, CR-Touch
    with visual offset diagram and per-probe defaults
    - Bed mesh map: zone config, grid resolution (3–11 pts), algorithm (bicubic/lagrange),
    fade settings, simulated heatmap with heat coloring and stats
    - Klipper config generator: full printer.cfg output with probe section,
    bed_mesh, safe_z_home, screws_tilt_adjust, START/END_PRINT macros,
    copy-to-clipboard and download
    https://claude.ai/code/session_01MgZBhzqDaUsA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
2026-08-09 feat: refactor complet — EBB42 v1.2 + BTT U2C v2.1 + Cartographer CAN sur RatOS v2.1
    Refactoring complet basé sur la documentation officielle et sources communautaires.
    Corrections techniques vs version Bolt :
    - U2C v2.1 = pont USB→CAN uniquement, pas de [mcu u2c] Klipper
    - Cartographer v5 : [mcu scanner] + [scanner] avec sensor: cartographer
    - stepper_z : homing_retract_dist: 0 obligatoire avec Cartographer
    - rotation_distance Orbiter 2.0 : 4.637 (Bolt avait 33.5 — incorrect)
    - Z_TILT_ADJUST 3 vis VCore 3.1 avec points calculés par taille plateau
    - zero_reference_position dans bed_mesh pour Cartographer
    - canbus_interface: can0 explicite sur [mcu EBB42]
    - mcu nommé EBB42 (conventi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
2026-08-09 feat: add Diagnostic tab with live Moonraker connection
    - Add PrinterDiagnostic component: connects to the printer's Moonraker
    API (configurable IP/port) directly from the browser
    - 10+ automated checks: Klipper state, MCU principal, EBB42 CAN,
    Cartographer CAN, homing axes, Z_TILT, bed mesh, probe calibration,
    hotend/bed temperature sensors, recent error detection
    - Live temperature display: hotend, bed, chamber, EBB42, Octopus
    - Print stats panel when a print is in progress
    - Auto-refresh every 5 seconds with manual refresh button
    - Collapsible recent error log section (GCode store, last 100 lines)
    - Add 'diagnostic' tab to App navigation (Activity icon)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
2026-08-09 feat(diagnostic): refactor avec fonctionnalités uniques vs Mainsail
    - Validation config Klipper chargée : homing_retract_dist=0,
    endstop_pin=probe:z_virtual_endstop, zero_reference_position,
    canbus_interface=can0, input shaper
    - Santé CAN Bus : parse last_stats MCU → retransmit, bad_crc,
    out_of_order par device (EBB42 + Cartographer)
    - Analyse Bed Mesh : min/max/range/stddev + note planéité
    (Excellent/Bon/À améliorer/Mauvais) + heatmap Z colorée
    - Actions rapides : G28, Z_TILT_ADJUST, BED_MESH_CALIBRATE,
    SAVE_CONFIG, FIRMWARE_RESTART, CARTOGRAPHER_CALIBRATE
    - Envoi GCode custom depuis l'interface
    - Bouton 'Envoyer' inline sur chaque check échoué
    - Ressources système Ra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
2026-08-09 feat(diagnostic): topologie CAN + comparaison printer.cfg
    - Topologie visuelle : Pi → USB → U2C → CAN → EBB42 / Cartographer
    avec statut sur chaque lien (détection U2C via /machine/system_info
    usb_devices, état can0, bitrate vs config attendue)
    - Comparaison printer.cfg : bouton 'Charger printer.cfg' qui fetch
    /server/files/config/printer.cfg depuis Moonraker, puis compare
    les paramètres critiques vs la config générée par l'app (tableau
    avec colonne Attendu / Réel / État, mise en évidence des critiques)
    - Export generateConfig depuis ConfigGenerator pour réutilisation
    - PrinterDiagnostic accepte config: PrinterConfig pour génération live
    du config de référen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
2026-08-09 feat(diagnostic): tests matériel dédiés U2C / EBB42 / Cartographer
    U2C v2.1:
    - Détection USB (vendor 1d50:606f), état can0, bitrate vs config attendue
    - Alerte si vitesse CAN incohérente avec la config de l'app
    - Bouton 'Vérifier connectivité CAN'
    EBB42 v1.2:
    - Firmware, stats CAN (retransmit/bad_crc), MCU temp, MCU awake%
    - Test ADXL345 (ACCELEROMETER_QUERY) → affiche X/Y/Z + norme
    - Mesure bruit axes (MEASURE_AXES_NOISE) → note si bruit XY élevé
    - Lecture endstops (/printer/query_endstops/status) → état X/Y/Z
    - Test ventilateur 3s (M106 S128 → G4 P3000 → M107)
    Cartographer:
    - Firmware + CAN health + fréquence capteur + température + dernier Z
    - Position de calibrat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
2026-08-09 feat(diagnostic): apply & save config fixes to printer.cfg via Moonraker
    - Add applyFix() helper: modifies a section/key value in raw cfg text,
    inserting the key if absent
    - Add modifiedCfg / saveStatus / saveMsg state for pending edits
    - fetchPrinterCfg now initialises modifiedCfg from the loaded file
    - Add applyOneFix(diff): applies a single row correction
    - Add applyAllCriticalFixes(): applies all critical mismatches at once
    - Add saveCfg(): POST /server/files/upload to write back to Pi
    - diffLines now compares against modifiedCfg (falls back to actualCfg)
    so corrections show as resolved before saving
    - Diff table gains a 5th column with per-row 'Remplacer' buttons
    - Action bar above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
2026-08-10 feat(diagnostic): UUID discovery + CAN error rate + connection diagnosis
    EBB42 & Cartographer:
    - Show configured canbus_uuid in a status banner (green if set, red if empty)
    - Clear ✓/✗ connection status with list of likely causes when not visible
    - New 'Erreurs/min (live)' stat cell — calculates retransmit delta between
    polls so CAN bus degradation appears immediately (not just cumulative total)
    UUID Discovery panel (between U2C and EBB42):
    - Displays current UUIDs configured in the app (green/red)
    - Shows copy-ready SSH commands for canbus_query.py and flashtool.py
    - Textarea to paste command output; 'Analyser' button extracts all 12-char
    hex UUIDs via regex
    - Per-UUID '→ EBB42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
2026-08-10 fix: handle [mcu toolhead] and [mcu u2c] naming used by RatOS v2.1
    - Replace all objects['mcu EBB42'] references with ebbMcu derived variable
    (resolves to objects['mcu EBB42'] ?? objects['mcu toolhead'])
    - Replace temperature_sensor EBB42 with ebbTempSensor derived variable
    (resolves to objects['temperature_sensor EBB42'] ?? objects['temperature_sensor toolhead'])
    - Update CAN error rate calculation to fall back to 'mcu toolhead' stats
    - Update buildRuntimeChecks to check both 'mcu EBB42' and 'mcu toolhead'
    - Update buildConfigChecks to check both 'mcu toolhead' and 'mcu EBB42' sections
    - Update COMPARE_KEYS to use pipe-separated fallback 'mcu toolhead|mcu EBB42'
    - Update diffConfigs to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
2026-08-10 feat: add flash firmware tools for EBB42 and Cartographer
    New collapsible section 'Flash Firmware' in the Diagnostic tab with:
    EBB42 v1.2 — Via CAN (Katapult installed):
    - Stop Klipper
    - Reset to Katapult bootloader via flashtool.py -r -u <UUID>
    - Verify Katapult responds
    - Build Klipper (STM32G0B1, 8KiB offset, CAN PB0/PB1) with menuconfig hints
    - Flash via flashtool.py -f klipper.bin -u <UUID>
    - Restart Klipper
    EBB42 v1.2 — Via USB/DFU (first install):
    - DFU mode (BOOT + RESET)
    - lsusb verification
    - Build Katapult with menuconfig settings
    - Flash via dfu-util
    - Then switch to CAN method for Klipper
    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
2026-08-13 feat(diagnostic): détection auto des problèmes config + corrections guidées
    - Ajoute analyzeConfigProblems() qui analyse le printer.cfg chargé pour :
    • Macros GCode dupliquées ([gcode_macro LED_ON] × 2, etc.)
    • Conflit [beacon] + [cartographer] → Can't register 'probe'
    • [mcu u2c] commenté mais UUID confirmé actif
    - Auto-fix pour macros dupliquées (removeDuplicateMacros)
    - Auto-fix pour section [beacon] à commenter (commentBeaconSection)
    - Détection runtime : patterns d'erreur Klipper connus (probe conflict, mcu unable to connect)
    avec explication cause + commandes SSH de diagnostic
    - printer.cfg chargé automatiquement à la première connexion (useEffect)
    -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
2026-08-13 feat: onglets Terminal, Câblage et RatOS + correction du diagnostic probe
    Nouvelle approche fondée sur l'architecture réelle de RatOS v2.1.x
    (vérifiée sur le dépôt Rat-OS/RatOS-configuration).
    Nouveaux composants
    - lib/moonraker.ts : couche d'accès partagée (connexion persistée en
    localStorage, envoi G-code, gcode_store, objects/list, klippy.log,
    extraction et analyse des tracebacks Python)
    - PrinterTerminal : console G-code temps réel avec historique clavier,
    bibliothèque de commandes, découverte des [gcode_shell_command]
    réellement configurés via /printer/objects/list, et lecteur de
    klippy.log qui isole les tracebacks et met en évidence les modules
    tiers impliq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
2026-08-13 fix(diagnostic): aligner la vitesse CAN sur la valeur détectée en un clic
    L'app par défaut sur 500k signalait une erreur sur les bus à 1 Mbit/s,
    alors que c'est la valeur réelle de can0 qui fait foi. L'avertissement
    explique maintenant les deux cas de figure et propose un bouton pour
    adopter la vitesse détectée.
    Retire aussi un import lucide inutilisé.
    Claude-Session: https://claude.ai/code/session_01MgZBhzqDaUsA1XaN7FJfaV
2026-08-13 fix(diagnostic): identifier la cause exacte de l'erreur probe
    La cause est confirmée par lecture des deux sources :
    cartographer.py, classe CartographerProbe, enregistre la commande
    "probe" en minuscules alors que toutes ses autres commandes sont en
    majuscules. klippy/gcode.py::register_command rejette tout nom non
    majuscule pour les commandes non traditionnelles, d'où le message
    "Can't register 'probe' as it is an invalid name".
    Ce n'est ni un conflit entre plugins de sonde, ni une erreur de
    configuration : c'est une coquille du plugin que la validation de
    Klipper a fini par rattraper, RatOS mettant Klipper à jour sans mettre
    à jour le plugin.
    Le diagnostic affiche maintenant les deu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
2026-08-13 docs: journal de dépannage de la machine
    Consigne les quatre pannes résolues avec leur cause exacte et le correctif :
    bug de casse dans register_command du plugin Cartographer, accès à l'attribut
    privé _mcu_freq déplacé par un refactor de Klipper, permutation des canbus_uuid
    entre EBB42 et Cartographer, et section [mcu u2c] superflue.
    Documente aussi la dette restante : firmware des MCU en retard d'une version
    majeure sur l'hôte, et patchs du plugin qui sauteront à la prochaine mise à jour.
    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
2026-08-14 feat(machine): leds.cfg — éclairage d'état par étape d'impression
    Macros STATUS_* pour neopixels (couleurs) et COB (intensité seule,
    un COB étant monochrome) : chargement, homing, chauffe avec dégradé
    bleu→rouge suivant la température réelle via delayed_gcode, z-tilt,
    mesh, impression, pause, fin, erreur.
    Un veilleur d'état réagit aux transitions pause/reprise/fin/erreur
    sans écraser les couleurs d'étape pendant START_PRINT.
    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
    [leds.cfg]
2026-08-15 feat: onglet Migration 2.1.0 — procédure carte SD + flash MCU + scripts
    Nouvel onglet guidant la migration RC2 vers 2.1.0 par carte SD neuve,
    avec retour arrière par simple échange de carte. Huit phases avec
    checklist persistée en localStorage :
    1. Sauvegarde (script migration-backup.sh : config, base Moonraker,
    fichiers patchés du plugin, .config menuconfig, manifeste versions)
    2. Flash de l'image 2.1.0 sur une carte SD neuve
    3. Premier boot et restauration ciblée (printer.cfg + fichiers perso)
    4. Réinstallation du plugin Cartographer + réapplication des 2 patchs
    5. Flash Octopus Pro 446 (menuconfig USB, méthode carte SD BTT)
    6. Flash EBB42 via Katapult CAN (menuconfig CAN PB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
2026-08-15 feat: onglet Audit .cfg — vérification du printer.cfg réel de l'imprimante
    Nouveau moteur de règles (lib/cfgAudit.ts) qui analyse le printer.cfg
    chargé depuis Moonraker (ou collé à la main) contre tous les pièges
    rencontrés sur cette machine :
    - Permutation des canbus_uuid entre [mcu toolhead] et [cartographer],
    avec les UUID vérifiés de la machine en référence
    - Même UUID dans deux sections (Duplicate canbus_uuid)
    - UUID invalide (000000000000, vide, mauvais format)
    - [mcu u2c] actif
    - Sections déclarées plusieurs fois (avec numéros de ligne)
    - Conflits de sonde : [beacon]+[cartographer], include z-probe résiduel
    - stepper_z : endstop_pin virtuel et homing_retract_dist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
2026-08-15 fix(câblage): rendre visibles les cartes dans les schémas RatOS
    Les wiring.drawio.svg de RatOS référencent les images des cartes
    (EBB42.webp, nema17.png, psu.png…) en URL absolues vers os.ratrig.com.
    Or un SVG affiché via <img> a interdiction de charger toute ressource
    externe : les tracés vectoriels (fils, étiquettes) apparaissaient,
    les cartes et connecteurs bitmap restaient invisibles.
    Nouveau composant RemoteSvg : télécharge le SVG en texte, réécrit les
    éventuels href relatifs en absolus, retire les dimensions figées, et
    injecte le SVG inline — le navigateur charge alors les images
    normalement. Fond du cadre passé en sombre (les schémas RatOS sont
    conçus avec étique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
2026-08-15 feat(audit): correction automatique du printer.cfg avec garde-fous
    Chaque problème corrigeable de l'audit porte maintenant sa correction,
    applicable en trois temps depuis l'onglet :
    1. Sélection — les erreurs sont cochées par défaut, les avertissements
    non ; chaque case affiche exactement ce qui sera fait
    2. Aperçu — les corrections sont appliquées EN MÉMOIRE, le résultat est
    ré-audité et affiché (erreurs avant → après), le fichier complet
    corrigé est consultable ; rien n'est écrit
    3. Sauvegarde — trois protections :
    - garde anti-écrasement : relecture du fichier sur le Pi et
    comparaison avec la version analysée ; s'il a changé entre-temps
    (ong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
2026-08-15 fix: cache HTTP sur les lectures de fichiers + comparaison numérique tolérante
    Deux causes de fausses alertes corrigées :
    1. Les fetch de printer.cfg et klippy.log n'imposaient pas
    cache: 'no-store' — le navigateur pouvait resservir une copie
    périmée du fichier. Conséquence réelle observée : l'audit a analysé
    la version d'avant-corrections (9.9 kB) alors que le Pi hébergeait
    la version corrigée (10.8 kB) et que Klipper tournait — verdict
    « 7 problèmes bloquants » entièrement faux. Toutes les lectures de
    fichiers passent en no-store, y compris la garde anti-écrasement de
    l'auto-fix qui comparait potentiellement du cache à du cache.
    2. La comparaison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
2026-08-15 fix(diagnostic): un Klipper ready prouve la connexion des MCU configurés
    Le diagnostic affichait EBB42 et Cartographer « Absents » alors que
    Klipper était READY — contradictoire par construction : Klipper ne
    démarre jamais tant qu'un MCU configuré ne répond pas. La détection
    repose maintenant sur deux niveaux :
    - l'objet mcu remonté par Moonraker quand il est disponible
    (sélection « alive-first » : on préfère l'instance qui expose
    mcu_version au lieu d'un ?? sur la présence de clé, qu'une clé
    vide pouvait court-circuiter)
    - sinon, ready + section présente dans configfile ⇒ connecté
    Corrige aussi la version Klipper affichée « — » (le champ s'appelle
    softwar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
2026-08-15 feat: écran d'erreur explicite à la place de la page blanche
    Un ErrorBoundary au niveau racine affiche désormais le message et la
    stack de toute erreur de rendu, au lieu de laisser React démonter
    l'application en silence. Indispensable pour diagnostiquer à distance :
    une page blanche ne dit rien, un écran d'erreur dit tout.
    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
2026-08-15 fix(diagnostic): last_stats peut être un objet — crash matchAll corrigé
    parseMcuStats supposait que last_stats était la chaîne historique
    « clé=valeur ... » et appelait matchAll dessus. Les Moonraker récents
    renvoient un objet {clé: valeur} : TypeError au premier rendu avec des
    données réelles, donc dès que l'imprimante est ready — le crash
    n'apparaissait jamais tant que Klipper était en erreur et les objets
    mcu vides. La fonction accepte maintenant les deux formats.
    Reproduit et validé avec des réponses Moonraker simulées au format
    objet : plus d'erreur de page.
    Claude-Session: https://claude.ai/code/session_01M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
2026-08-15 chore: retirer un script de test commité par erreur
    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
2026-08-15 feat: config de l'app persistée + UUID auto-adoptés depuis l'imprimante
    Deux défauts qui produisaient les cartouches « UUID non configuré »
    malgré une imprimante fonctionnelle :
    - La configuration de l'app (UUID, vitesse CAN, matériel…) ne vivait
    qu'en mémoire React : chaque rechargement de page la remettait aux
    défauts. Elle est maintenant persistée en localStorage, fusionnée
    avec les défauts au chargement pour que les champs ajoutés par les
    mises à jour gardent leur valeur.
    - À la connexion, le Diagnostic adopte automatiquement les canbus_uuid
    lus dans la config réellement chargée par Klipper quand les champs
    de l'app sont vides — sans jamais écraser un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
2026-08-15 feat(machine): thème Mainsail « RatOS Orange » via .theme/custom.css
    Habillage purement cosmétique chargé par le mécanisme officiel de
    Mainsail (dossier .theme du répertoire config) : cartes arrondies à
    bordures fines, barre et menu latéral assombris avec capsule active
    orange, boutons et champs adoucis, console en fonte machine, tableaux
    et sliders accordés, barres de défilement discrètes.
    Aucune modification du système : un fichier CSS dans la config,
    supprimable à tout moment, sans police externe pour rester hors-ligne.
    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
2026-08-18 docs(z): protocole de diagnostic Z + bloc de surcharge prêt à appliquer
    Retire la conclusion « deux pannes indépendantes » sur l'axe Z : le mapping
    physique s'est inversé entre les deux séries de tests, donc des câbles ont
    bougé sans être tracés et la chaîne de preuve ne tient plus. Remplacée par
    une matrice à deux tests à variable unique, plus une mesure de continuité
    qui arbitre câble contre moteur sans faire intervenir Klipper.
    Ajoute machine/z-axis.cfg : inversion des trois dir_pin, repli de stepper_z2
    sur MOTOR5, controller_fan sur PD12, et le brochage des slots moteur.
    Corrige aussi une hypothèse fausse de la liste de travail : [z_tilt] est
    probablement fourni par l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
    [z-axis.cfg]
2026-08-19 docs(config): valeurs officielles RatOS + cause du bruit moteurs
    La configuration de la machine est autonome : pas de dossier RatOS/, aucun
    [include]. Elle n'hérite de rien et a perdu les réglages que RatOS
    appliquait. La référence reste dans .RatOS_repo_backup/ sur la machine.
    Remplace le [z_tilt] extrapolé par les coordonnées de v-core-3/400.cfg,
    réordonnées pour le câblage réel (z=arrière, z1=avant-gauche, z2=avant-droit)
    selon la convention que RatOS documente dans steppers.cfg.
    Identifie la cause du grognement des cinq moteurs : max_z_accel 300, soit
    deux fois le profil performance de RatOS et dix fois son profil prudent.
    Écarte au passage deux fausses pistes que j'avais a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
    [z-axis.cfg]
2026-08-19 feat(machine): printer.cfg corrigé de la VCore 3.1
    Applique au fichier réel les corrections établies par comparaison avec
    .RatOS_repo_backup/printers/v-core-3/ : limites de vitesse, [z_tilt]
    absent alors que START_PRINT l'appelle, courants X/Y ramenés sous le
    plafond du TMC2209, sens Z inversés, et bornes de bed_mesh qui
    envoyaient la sonde hors plateau.
    Supprime les blocs morts : ancien stepper_z2 sur MOTOR4, doublon commenté
    de tmc2209 stepper_z1, diag_pin/SGTHRS résiduels de l'époque sensorless.
    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
    [printer.cfg]
2026-08-19 docs(z): protocole de diagnostic à variable unique, reprise à zéro
    Les conclusions antérieures sur l'axe Z sont retirées. Le nom « z1 » a
    désigné trois vis différentes au fil du dépannage : les tests ne mesuraient
    pas ce que je croyais, et rien de ce qui en a été déduit ne tient.
    Le protocole réduit la configuration à UN seul stepper Z pendant le
    diagnostic, avec un seul moteur et un seul câble, de sorte que le slot soit
    la seule variable et qu'aucune confusion de nom ne soit possible.
    Fixe aussi une convention de nommage définitive, alignée sur celle que RatOS
    documente, pour que z_positions se recopie sans réordonner.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
2026-08-19 fix(machine): déplace stepper_z1 sur MOTOR6 et stepper_z2 sur MOTOR7
    MOTOR3 ne délivrait aucun courant (moteur libre à la main, panne prouvée
    côté carte par échange des câbles) et MOTOR5 alimentait sans faire tourner.
    Les deux steppers sont déplacés sur MOTOR6 et MOTOR7, slots neufs jamais
    utilisés, avec les broches officielles de la carte octopus-pro-446.
    Les broches sont vérifiées contre les alias z1_*/z2_* de
    .RatOS_repo_backup/boards/btt-octopus-pro-446/config.cfg.
    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
    [printer.cfg]
2026-08-19 docs: panne Z résolue — deux slots morts sur l'Octopus Pro neuve
    Les trois vis tournent après déplacement de stepper_z1/z2 sur MOTOR6/MOTOR7.
    Cause confirmée : MOTOR3 et MOTOR5 défaillants sur une carte neuve (MOTOR4
    déjà écarté). Moteurs, câbles et drivers tous sains, prouvé par l'échange
    des câbles qui a laissé la panne sur le connecteur.
    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
2026-08-19 docs: panne 6 — get_offsets() incompatible plugin Cartographer / Klipper
    Troisième incompatibilité de signature du même type que les pannes 1 et 2 :
    probe.py de Klipper appelle get_offsets(gcmd), cartographer.py ne l'accepte
    pas. Ne se déclenche qu'au premier Z_TILT_ADJUST, une fois la sonde calibrée.
    Correctif d'une ligne, à réappliquer après tout git pull du plugin.
    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
2026-08-19 feat(machine): migre la sonde de cartographer.py vers scanner.py
    cartographer.py est en retard sur l'API sonde de Klipper récent : il renvoie
    des listes là où homing.py/probe.py attendent des objets .bed_z, d'où le
    plantage au premier G28 Z / Z_TILT_ADJUST. homing.py est standard (git propre),
    donc c'est bien le plugin qui est en cause.
    Bascule [cartographer] → [mcu scanner] + [scanner] (module maintenu, écrit
    pour cette API), d'après le gabarit officiel scripts/setup.py. Documente la
    panne 7 et l'obsolescence des patchs pannes 1/2/6.
    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
    [printer.cfg]
2026-08-19 docs: procédure de flash de la sonde Cartographer en 5.1.0
    Complète la panne 7 : scanner.py exige le firmware 5.1.0 (commande
    cartographer_home avec trigger_method, absente de 2.2.0). Documente le flash
    CAN par UUID via Katapult, y compris le piège canbus_query « 0 uuids » quand
    les cartes ont déjà un node-id attribué par Klipper.
    Flash réalisé et vérifié (SHA OK) sur la sonde 4973681e12df.
    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
2026-08-19 fix(machine): bed_mesh limité au PEI imprimable 350×350
    Le plateau imprimable réel est 350×350, pas 400. Resserre mesh_max de
    365,360 à 330,330, recentre zero_reference_position sur 175,175 et réduit
    probe_count à 15×15. Évite de palper hors zone d'impression. Le z_tilt
    reste inchangé : la plaque alu, plus grande que le PEI, permet à la sonde
    d'y mesurer ses points.
    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
    [printer.cfg]
2026-08-19 fix(machine): bed_mesh mesh_min Y=30 pour l'offset de sonde
    Palper à Y<21,1 forçait la buse à Y négatif (sonde 21,1 mm derrière la buse)
    -> Move out of range. Relève mesh_min Y de 20 à 30.
    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
    [printer.cfg]
2026-08-19 fix(machine): bed_mesh calé sur le PEI réel (40-350 en X et Y)
    Le maillage débordait sur le bord de plaque, produisant une falaise à
    -1.655 mm au coin. Cale mesh_min/max sur le PEI réel avec 5 mm de marge
    (45..345) et recentre zero_reference_position sur 195,195.
    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
    [printer.cfg]
2026-08-19 fix(machine): bed_mesh calé sur les coins du PEI mesurés à la buse
    Coins relevés physiquement : avant-gauche (32,33), arrière-droit (380,371).
    mesh 40,40 → 375,368 (marge ~5 mm), zero_reference 205,200. Le maillage
    précédent (20→330) débordait avant le PEI et s'arrêtait 50 mm avant sa fin.
    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
    [printer.cfg]
2026-08-19 tweak(machine): z_tilt speed 300 mm/s pour accélérer le nivellement
    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
    [printer.cfg]
2026-08-19 fix(machine): resserre bed_mesh à 55-355/350 pour éviter le biseau du PEI
    mesh_max Y=368 palpait à 3 mm du bord PEI (371), créant un creux artificiel
    de -0,8 mm au coin. Marge portée à ~18 mm : mesh 55,55 → 355,350.
    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
    [printer.cfg]
2026-08-19 feat(machine): macros d'impression adaptées de la config de l'ami
    START_PRINT avec heat-soak par temporisation, maillage adaptatif, park et
    purge ; END_PRINT, PARK_HOTEND, PRIME_LINE. Retire les dépendances au caisson
    régulé et au système de LED par états que cette machine n'a pas ; utilise
    LED_ON/LED_DIM et une purge calée sur le PEI (40,45).
    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
    [printer.cfg]
2026-08-19 feat(app): onglet « Générateur .cfg » multi-fichiers
    Nouvel onglet qui génère les fichiers périphériques calés sur la machine :
    Macro.cfg (START_PRINT/END_PRINT/PARK_HOTEND/PRIME_LINE, heat-soak et
    maillage adaptatif), leds.cfg (macros LED par étape sans le plugin
    led_effect), Shaketune_macros.cfg et sonar.conf. Sélecteur de fichier,
    copier, télécharger, et « tout télécharger ». Les contenus s'adaptent aux
    options de la config (taille, LED neopixel/COB, ventilo caisson).
    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
2026-08-19 feat(app): générateur — ajoute leds-effects, hooks Mainsail, timelapse
    Trois fichiers de plus dans l'onglet Générateur : leds-effects.cfg (LED
    animées via le plugin led_effect, effets par état d'impression, avec alias
    LED_* compatibles START_PRINT), client-macros.cfg (hooks Mainsail
    pause/reprise/annulation branchés sur les LED) et timelapse.cfg (parking
    calé sur la taille du plateau). Sept fichiers générés au total.
    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
2026-08-20 feat(app): générateur — ajoute chamber.cfg et moonraker-updates.cfg
    chamber.cfg : [temperature_fan chamber] régulé (capteur + ventilo enceinte)
    et macros de filtration START_FILTER/STOP_FILTER/PURGE_CAISSON, calés sur les
    broches de la config. moonraker-updates.cfg : blocs update_manager pour
    cartographer, led_effect, Shake&Tune et timelapse. Neuf fichiers au total.
    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
2026-08-20 feat(app): générateur — ajoute le BTT Smart Filament Sensor V1.0
    filament-sensor.cfg : [filament_motion_sensor SFS] sur le port Z-STOP libre
    (PG10) de l'Octopus, détection fin de filament + bourrage, runout_gcode avec
    PAUSE (et LED_ERREUR si LED configurées), macros SFS_ENABLE/DISABLE et
    consignes de câblage. Dix fichiers au total.
    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
2026-08-20 fix(app): capteur filament sur le connecteur SENSOR (PB7) au lieu de Z-STOP
    L'Octopus a un connecteur SENSOR dédié (VS/GND/PB7) qui apporte le 5V : le
    SFS s'y branche sans câbler l'alim à part. PB7 est libre (sonde Z = Cartographer
    sur CAN).
    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
2026-08-20 feat(app): active le capteur filament automatiquement dans START/END_PRINT
    SET_FILAMENT_SENSOR SFS ENABLE=1 après PRIME_LINE et ENABLE=0 en fin, gardés
    par « {% if printer['filament_motion_sensor SFS'] is defined %} » : sans effet
    si le capteur n'est pas configuré, donc aucun risque d'Unknown command.
    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
2026-08-20 feat(machine): workflow n8n de détection d'anomalie par GPT-4o vision
    Workflow importable : toutes les 45 s, vérifie via Moonraker qu'une impression
    tourne, capture un snapshot webcam, l'envoie à GPT-4o vision (verdict JSON
    echec/confiance/raison), et si échec confirmé (confiance >= 0.7) met en PAUSE
    et affiche le motif à l'écran. Équivalent maison d'Obico/Spaghetti Detective.
    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
2026-08-20 feat(app): onglet « Détection IA » — anti-spaghetti n8n + GPT-4o
    Nouvel onglet qui génère le workflow n8n de détection d'anomalie, paramétré
    (IP imprimante depuis la connexion Moonraker, URL snapshot, cadence, seuil de
    confiance) avec estimation de coût en direct. Pipeline visuel, guide
    d'installation pas à pas, avertissements et suggestion de notification.
    Copier / télécharger le JSON.
    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
2026-08-22 config(toolhead): update EBB42 CAN UUID after board replacement
    L'ancien EBB42 avait un TMC2209 extrudeur défectueux (lecture UART
    morte, moteur qui se verrouille sans tourner). Remplacé par un EBB42
    neuf, flashé avec le même firmware Klipper (STM32G0B1, quartz 8 MHz,
    CAN PB0/PB1 @ 1M, sans bootloader) via DFU.
    Nouveau canbus_uuid du [mcu toolhead]: e3be9642b024 (ancien: 564fed93e397).
    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
    [printer.cfg]
2026-08-23 feat(app): fichier macros-utiles.cfg (filament, préchauffe, parking, tests)
    Ajoute un générateur macros-utiles.cfg à l'onglet Générateur .cfg :
    LOAD/UNLOAD_FILAMENT, M600, PREHEAT_PLA/PETG/ABS, COOLDOWN,
    PARK_CENTER/FRONT/BED_BACK, TEST_SPEED, CALIBRATION_CUBE_PREP.
    Coordonnées calées sur la taille du plateau, gestion auto du capteur SFS.
    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
2026-08-23 feat(app): macros résonance/accéléromètre + aide OrcaSlicer
    resonance-macros.cfg : ACCEL_TEST, ACCEL_NOISE, RESONANCE_X/Y,
    CALIBRATE_SHAPER (input shaper), avec prérequis adxl345/resonance_tester
    et point de mesure calé sur le centre plateau.
    orcaslicer.cfg : G-code machine START_PRINT/END_PRINT à coller dans
    OrcaSlicer, mappé sur les placeholders de température d'Orca.
    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
2026-08-24 fix(mesh): horizontal_move_z 5->2 (coil hors plage calibrée -> Z aberrants)
    À horizontal_move_z: 5, le coil du Cartographer scanne au bord extrême de
    sa plage calibrée (model_range 0.1-5 mm). Sur les zones basses du plateau
    la distance dépasse 5 mm, le coil sort de sa plage, le modèle extrapole et
    sort des Z délirants (mesh min/max à des milliers) -> 'Mesh extends outside
    of the fade range'. 2 mm garde une marge des deux côtés.
    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
    [printer.cfg]
2026-08-24 feat(ia): porte AI_GUARD pour piloter la détection IA depuis Mainsail
    Ajoute un interrupteur ON/OFF natif (variable Klipper) lu par n8n via
    Moonraker — pas de webhook ni gcode_shell_command.
    - ai-detection.cfg (générateur) : AI_GUARD + DETECTION_ON/OFF/STATUS
    - n8n workflow (JSON + AnomalyDetection.tsx) : lit gcode_macro AI_GUARD
    et n'analyse l'image que si print_stats=printing ET AI_GUARD.enabled=1
    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
2026-08-25 feat(mesh): [exclude_object] pour le bed mesh adaptatif + annulation d'objet
    BED_MESH_CALIBRATE ADAPTIVE=1 était présent mais sans [exclude_object],
    Klipper n'a pas les emprises d'objets et ne peut pas limiter le mesh à la
    zone imprimée. Ajoute la section (requiert 'Label objects' côté slicer).
    Active aussi l'annulation d'objet dans Mainsail.
    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
    [printer.cfg]
2026-08-25 feat(macros): _ON_LAYER_CHANGE pour compat OrcaSlicer + compteur de couches
    Le preset RatRig d'OrcaSlicer appelle _ON_LAYER_CHANGE à chaque couche.
    Absent d'une config autonome -> 'Unknown command' à chaque couche. La macro
    met aussi à jour le compteur de couches Mainsail via SET_PRINT_STATS_INFO.
    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
2026-08-25 chore(moonraker): moonraker.conf propre sans le bloc RatOS cassé
    Retire l'include RatOS/moonraker.conf et [update_manager client RatOS]
    (chemin ~/printer_data/config/RatOS inexistant sur cette config autonome),
    sources des avertissements Moonraker. Base = sauvegarde fonctionnelle,
    tous les autres update_manager conservés.
    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
2026-08-31 feat(app): générateur de profils filament OrcaSlicer (PLA/PETG/ABS/ABS+)
    Nouvel onglet 'Profils Filament' qui génère des fichiers .json au vrai
    format OrcaSlicer (type:filament, valeurs en tableaux de chaînes,
    inherits vers un profil de base, compatible_printers vide) — donc
    réellement importables, contrairement aux fichiers manuels qui donnaient
    '0 configuration importée'.
    Réglages adaptés à la VCore 3.1 + Rapido HF + Orbiter direct drive:
    - PLA: buse 210/215, lit 60, ventilo 100%, vol 15
    - PETG: buse 240, lit 80, ventilo 30-50%, vol 12
    - ABS: buse 245/250, lit 100-105, ventilo 0-20%, vol 14
    - ABS+: buse 250/255, ventilo 0-15%, vol 13
    Pressure Advance désactivé côté Orca (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
2026-08-31 fix(filaments): inherits vers vrais presets OrcaSlicer (Generic PLA/PETG/ABS)
    Les fichiers donnaient '0 configuration importée' car inherits pointait
    vers fdm_filament_pla/pet/abs — des noms internes PrusaSlicer/SuperSlicer
    qui n'existent pas dans OrcaSlicer. Le parent introuvable = preset rejeté.
    - inherits -> 'Generic PLA' / 'Generic PETG' / 'Generic ABS' (presets
    système réels OrcaSlicer)
    - ajout de filament_settings_id (identifiant du preset attendu par Orca)
2026-08-31 feat(filaments): ajout profils TPU et Carbone (PETG-CF)
    - TPU 95A : buse 225, lit 40-45, vol max 4, retraction courte (0.4),
    ventilo 50-80%. Notes: imprimer lentement, direct drive obligatoire.
    - Carbone (PETG-CF) : buse 250, lit 80, filament_type PETG-CF, inherits
    Generic PETG. Notes: buse acier trempe obligatoire (abrasif), 0.6
    conseillee, secher +++, variantes PLA-CF / PA-CF documentees.
    - Rappels bas de page mis a jour (TPU + Carbone).
2026-08-31 feat(app): onglet Réglages Supports (faciles à enlever)
    Nouvel onglet 'Supports' avec les valeurs OrcaSlicer par materiau pour
    des supports qui se retirent sans casser la piece:
    - Regle d'or expliquee : Distance Z superieure (0 = soude, 0.2 = net)
    - Tableau par materiau (PLA/PETG/ABS/TPU/Carbone) : gap Z, angle de
    seuil, type arbre, densite, interface — avec copie par valeur
    - Principes de fond : reorienter, surplombs ~45-50 sans support,
    supports sur plateau uniquement, supports arbre
    - Section depannage si ca casse encore
2026-08-31 feat(filaments): tableau des réglages manuels (crayon) par matériau
    Sous chaque profil, affiche les valeurs exactes a recopier dans
    OrcaSlicer via le crayon, regroupees comme les onglets reels
    (Filament / Refroidissement / Forcage-Retraction), pour tous les
    materiaux (PLA/PETG/ABS/ABS+/TPU/Carbone). Valeurs derivees du meme
    preset (source unique) avec bouton copier par valeur.
    C'est la methode fiable (zero import qui plante).
2026-08-31 tune(filaments): rétraction par défaut 0.8 -> 0.5 mm (Orbiter 2.0 direct drive)
    L'Orbiter v2.0 a un chemin filament tres court : 0.5 mm est l'optimum
    typique (moins d'oozing/stringing sans manque au retour). Le TPU garde
    son override a 0.4 mm.
2026-08-31 feat(app): onglet Qualité & Calibration (anti-chevelure, Input Shaper, Orca)
    Nouvel onglet 'Qualite' avec 4 sections:
    - Anti-chevelure PETG : secher le filament (cause n1), temp, retraction,
    vitesse deplacement, wipe, z-hop
    - Input Shaper (Klipper) : MEASURE_AXES_NOISE, G28 + SHAPER_CALIBRATE,
    SAVE_CONFIG, avec boutons copier + note Pressure Advance
    - Calibration OrcaSlicer : temp tower, flow rate, PA, retraction, max
    volumetric speed (ordre conseille)
    - Reglages visuels : vitesse paroi ext, seam, ironing, parois, couches
2026-09-01 chore: titre de la page -> Ratrig VCore 3.1 (au lieu de l'ancien titre parking)
2026-09-03 feat(app): onglet Fiche Réglages imprimable (PDF) VCore 3.1 hybride
    Document de reference complet (calibration, mouvement, filaments, qualite,
    supports, depannage, START_PRINT) avec bouton Imprimer/PDF (window.print)
    et styles @media print dedies (fond blanc, texte noir, uniquement la fiche).
    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
2026-09-03 backup: bloc SAVE_CONFIG calibration VCore 3.1 (2026-09-03)
    Sauvegarde de secours des valeurs calibrees : PID extrudeur, modele
    scanner Cartographer 5.1.0 (scan), Input Shaper (X mzv 60.2 / Y 2hump_ei
    56.0), bed mesh 15x15. Note : model_offset a 0 (Z-offset a re-appliquer
    via Z_OFFSET_APPLY_PROBE + SAVE_CONFIG).
    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
    [SAVE_CONFIG-backup-2026-09-03.cfg]
2026-09-03 chore: supprime les vestiges du template parking — typecheck propre
    L'app est un configurateur VCore 3.1 / RatOS depuis la refonte, mais le
    squelette StackBlitz d'origine (tableau de bord de parking) restait dans
    l'arborescence sans qu'aucun composant ne le référence. Il portait à lui
    seul l'essentiel des 89 erreurs de `tsc --noEmit`, invisibles au build
    parce que `vite build` ne typecheck pas.
    Supprimé, après vérification qu'aucun fichier vivant n'y renvoie :
    src/pages/ (9 écrans), ParkingMap3D, Sidebar, contexts/AuthContext,
    lib/supabase, lib/database.types et la migration SQL du parking.
    Les dépendances qui n'existaient que pour eux partent avec :
    @react-three/{fiber,drei}, th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
2026-09-03 docs: points machine ouverts + lecture d'un QUERY_FILAMENT_SENSOR de mouvement
    DEPANNAGE-RATOS.md était un journal des pannes résolues : ce qui restait à
    faire sur la machine n'y figurait qu'éparpillé dans « Dette technique
    restante », ou pas du tout pour le Z-offset. Cinq actions réunies en tête du
    document, geste et commande, l'analyse restant à sa place plus bas :
    Z-offset Cartographer (model_offset toujours à 0), confirmation du
    [controller_fan] PD12, test du capteur SFS, reflash des MCU en v0.12 face à
    un hôte en v0.13, et la décision Cartographer / Beacon jamais tranchée.
    filament-sensor.cfg documente au passage un piège rencontré aujourd'hui :
    « QUERY_FILAMENT_SENSO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
2026-09-04 docs(depannage): panne 8 — heat creep par ventilateur de heatbreak à l'arrêt
    L'Orbiter grignotait après ~1 min d'impression : cause trouvée sur la
    machine, le ventilateur avant de la Rapido (refroidissement de la gorge, à
    ne pas confondre avec le ventilateur de pièce) ne tournait pas. La chaleur
    remonte, le filament ramollit dans la gorge et se coince ; le moteur garde
    son couple et claque. Le délai d'une minute est le temps de remontée de la
    chaleur, et l'extrusion à vide passait faute de temps pour que le heat creep
    s'installe.
    La section [heater_fan hotend_fan] de printer.cfg était correcte : la panne
    était matérielle. Le point « À faire » sur les ventilateurs est reform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
2026-09-04 fix(machine): Z-offset Cartographer calibré — model_offset 0 -> 0.170
    Le model_offset du scanner Cartographer était resté à 0.00000 : première
    couche écrasée sur toute vraie impression, alors qu'un STL de test sortait
    bien parce que rattrapé à la main au babystep. Cause unique, confirmée après
    avoir écarté planéité, maillage adaptatif (zero_reference_position réglé) et
    dérive thermique du scanner.
    Figé via Z_OFFSET_APPLY_PROBE + SAVE_CONFIG en console, buse chaude :
    model_offset -> 0.17000, model_temp 33.49 -> 36.58 (modèle de scan recalibré
    le même jour, d'où les nouveaux model_coef). Sauvegarde renommée en
    SAVE_CONFIG-backup-2026-09-04.cfg avec le bloc à jour.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
    [SAVE_CONFIG-backup-2026-09-04.cfg]
2026-09-05 fix: extrudeur = HGX Lite (pas Orbiter 2.0) — rotation_distance corrige
    L'extrudeur reel est un HGX Lite (reducteur 9.5:1, rotation_distance
    effectif ~5.56), pas un Orbiter 2.0 (4.637). Avec 4.637 configure, la
    machine sur-extrude d'environ 20% — cause probable des parois bombees
    et des lignes mal alignees en hauteur.
    - Ajout de hgx_lite dans HardwareSetup + ConfigGenerator + ExtruderType
    - defaultConfig passe a hgx_lite
    - Textes Orbiter -> HGX Lite dans Fiche Reglages, Profils Filament, Qualite
    - Depannage : sur-extrusion ajoutee comme suspect n1 des lignes desalignees
    Claude-Session: https://claude.ai/code/session_01MgZBhzqDaUsA1X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
2026-09-06 sync: machine/printer.cfg aligne sur la config reelle de la machine
    Le fichier du repo etait perime (macros PRIME_LINE/PARK_HOTEND obsoletes,
    includes manquants, rotation_distance Orbiter). Synchronise avec la config
    live du 2026-09-03 :
    - includes reels : macros-utiles, resonance-macros, filament-sensor, ai-detection
    - rotation_distance 4.637 -> 5.56 (HGX Lite, calibre au test 100 mm)
    - START_PRINT / END_PRINT remplaces par les versions reelles (purge sur PEI,
    parking centre-arriere X200, ligne SFS commentee = plus de fausse pause)
    - avertissement stepper_z2 perime remplace par l'etat reel de la machine
    Claude-Session: https://claude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
    [printer.cfg]
2026-09-06 config: PEI 400x400 (z_tilt + bed mesh) et fin des fausses pauses SFS
    PEI passe de 350x350 a 400x400 :
    - z_tilt points 40,40 / 200,370 / 360,40 (au lieu de 60,60 / 235,350 / 360,60)
    -> points bien plus proches des 3 vis = nivellement plus precis
    - bed_mesh 30,30 -> 370,370 (au lieu de 55,55 -> 355,350), zero_reference 200,200
    - reachabilite verifiee avec l'offset Cartographer y=+21.1 (tete y=8.9 a 348.9)
    Fausses pauses au demarrage :
    - un capteur de filament Klipper est ACTIF PAR DEFAUT : commenter le
    SET_FILAMENT_SENSOR ENABLE=1 dans START_PRINT ne desactivait rien
    - pause_on_runout: True -> False et PAUSE retire du runout_gcode
    - diagnostic LED documente pour reparer le capteur plus t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
    [filament-sensor.cfg, printer.cfg]
2026-09-06 config: coussin chauffant 400x400 230V 1400W sur SSR
    - pwm_cycle_time: 0.3 — obligatoire avec un SSR secteur (un SSR zero-cross
    ne commute qu'aux passages par zero du 50 Hz ; le defaut 0.1 s le hache)
    - max_power: 0.6 — 1400 W sur 1600 cm2 = 0.875 W/cm2, tres violent : on bride
    pour eviter l'overshoot
    - sensor_type Generic 3950 confirme correct pour la NTC 3950 1%
    - PID marque comme a recalibrer (les 2 reglages ci-dessus changent la reponse
    thermique, donc a mettre en place AVANT PID_CALIBRATE)
    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
    [printer.cfg]
2026-09-06 config: plateau 230V AC 1400W sur SSR + nettoyage des commentaires perimes
    - [heater_bed] : ajout max_power 0.6 et pwm_cycle_time 0.3 (indispensable
    avec un SSR secteur : un SSR zero-cross ne commute qu'aux passages par
    zero du 50 Hz, le defaut 0.1 s le hache et l'use)
    - PID marque comme a recalibrer (valeurs de l'ancien coussin)
    - en-tete : avertissement stepper_z2 obsolete remplace par l'etat reel
    - include filament-sensor commente : raison documentee (capteur muet, et
    un capteur Klipper est actif par defaut)
    - z_tilt : commentaire qui contredisait les nouvelles coordonnees corrige
    - bed_mesh : commentaire orphelin remplace, plages documentees
    - note ajoutee : le [bed_mesh default] s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
    [printer.cfg]
2026-09-07 feat(machine): macro CLEAN_NOZZLE pour brosse fixe chassis
    Sur une VCore 3 le portique est fixe en Z (le plateau monte/descend), donc
    la pointe de buse est toujours a la meme hauteur absolue : une brosse vissee
    au chassis est toujours au bon niveau. Aucun servo/moteur necessaire.
    - [_WIPE_CONF] : bloc de variables (x_start, x_end, y, z_clear, passes,
    speed, temp) avec la procedure de reglage des coordonnees
    - [CLEAN_NOZZLE] : descend le plateau AVANT tout XY, chauffe pendant le
    trajet, balaie N allers-retours, parametres TEMP= et PASSES=
    - documentation de l'integration dans START_PRINT / END_PRINT
    Claude-Session: https://claude.ai/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
    [nozzle-wiper.cfg]
2026-09-07 feat(machine): essuie-buse parametrique OpenSCAD (double levre + goulotte)
    Conception amelioree par rapport aux wipers courants :
    - deux levres silicone opposees : la buse est essuyee des DEUX cotes en un
    passage (au lieu d'un seul avec une levre unique)
    - trous oblongs verticaux : hauteur rattrapable quand le silicone s'use,
    sans reimprimer la piece
    - fentes recevant un insert silicone remplacable (pas de laiton qui raye)
    - goulotte inclinee sous le porte-levres pour evacuer les residus
    - gousset triangulaire sur le bras cantilever (rigidite au contact)
    Entierement parametrique : profile, entraxe vis, longueur de bras, ecart
    entre levres, epaisseur de bande, goulotte activable.
    Co-Aut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
    [nozzle-wiper.scad]
2026-09-08 feat(fiche): profils complets 6 materiaux, calibration par bobine, verdict slicer
    - nouveau bloc 02 : calibration PAR BOBINE (flow, PA, temp tower) — le point
    qui separe 'correct' de 'professionnel'
    - bloc Mouvement CORRIGE : affichait 500/10000 alors que la machine est a
    300/3000 dans son printer.cfg (valeurs conservatrices assumees)
    - profils filament etendus : buse 1ere/autres, plateau, ventilo, vol max,
    debit ET vitesse de paroi exterieure pour les 6 materiaux
    - nouveau bloc 'piege de chaque materiau'
    - nouveau bloc 'base commune qualite pro' (hauteur couche, largeur
    extrusion, parois, remplissage, vitesses)
    - bloc finition pro enrichi (joint en sifflet, seam gap)
    - nouveau blo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
2026-09-10 fix(start_print): amorcage de la buse avant la ligne de purge
    La ligne de purge demarrait a vide sur ses 20-40 premiers mm : apres la
    chauffe la buse s'est videe (coulure + retraction) et l'extrudeur doit
    d'abord remplir la chambre de fusion avant que la matiere sorte.
    - ajout d'un G1 E8 F180 sur place AVANT de tracer (amorcage)
    - 2e ligne en retour decalee de 0.7 mm : essuie la buse et confirme le debit
    - petite retraction finale pour eviter le fil vers la piece
    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
    [printer.cfg]
2026-09-11 fix(n8n): workflow detection anomalie reellement fonctionnel
    Deux bugs bloquants corriges :
    - l'image etait passee a OpenAI via une URL LAN (192.168.1.41) que leurs
    serveurs ne peuvent pas atteindre -> envoi en base64 inline
    - le test 'contains anomalie' se declenchait sur 'AUCUNE anomalie' ->
    sortie JSON stricte du modele + test booleen + seuil de confiance 0.8
    Autres corrections :
    - cle API en dur -> credential n8n predefini (openAiApi)
    - Pause Klipper passe en POST (Moonraker refuse le GET)
    - Telegram : operation sendPhoto + binaire repris depuis le noeud Snapshot
    (il etait perdu 3 noeuds plus loin)
    - garde 'impression en cours' avant d'analyser (inutile a l'arret)
    - cadence 1 min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
2026-09-11 docs(n8n): procedure credentials, test et reglages du workflow anomalie
    Documente durablement ce qui n'existait que dans la conversation :
    - chaine des noeuds et endpoints appeles
    - ou creer les 2 credentials (OpenAI, Telegram) et ou trouver leurs valeurs
    - avertissement : la cle OpenAI ne s'affiche qu'une fois a la creation
    - procedure de test sans impression (desactiver les 2 IF avec la touche D)
    - tableau des reglages (intervalle, seuil de confiance, modele, IP)
    - justification des choix de conception (garde, JSON strict, base64, fail-safe)
    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
2026-09-11 fix(n8n): extraction base64 robuste via noeud Code (corrige le 400 OpenAI)
    Le noeud GPT renvoyait 'Bad request'. Cause : l'expression inline
    binary.data.data ne renvoie le base64 que si n8n stocke les binaires EN
    MEMOIRE. En mode filesystem elle renvoie autre chose -> image vide dans
    le payload -> 400.
    - nouveau noeud Code 'Preparer l'image' : lit le binaire en memoire OU
    via helpers.getBinaryDataBuffer, et leve une erreur explicite si vide
    - il construit le payload OpenAI complet, donc inspectable AVANT envoi
    - le noeud HTTP se contente de JSON.stringify($json)
    - mimeType repris du binaire au lieu d'etre suppose jpeg
    Claude-Session: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
2026-09-12 feat(machine): poignee de porte de caisson parametrique (OpenSCAD)
    Poignee etrier obtenue par enveloppes convexes (hull de spheres et
    cylindres) : raccordements lisses sans aucun conge a poser, et surtout
    aucune esquisse a contraindre — l'ecueil qui bloquait sous SolidWorks.
    Parametres : entraxe, hauteur de prise, diametre de barre et de pied,
    percage/lamage selon la visserie, meplat de prise en main optionnel.
    Notes d'impression incluses : orientation couchee (couches paralleles a
    l'effort de traction, sinon delamination), PETG/ABS obligatoire car le PLA
    flue a la temperature d'un caisson.
    Claude-Session: https://claude.ai/code/sess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
    [poignee-caisson.scad]
2026-09-12 fix(poignee): barre bombee a rainures au lieu d'un etrier
    La premiere version etait une poignee a arche sur deux pieds — sans rapport
    avec le modele reel. D'apres la capture SolidWorks, la piece est une barre
    allongee legerement bombee, bouts arrondis, avec des rainures longitudinales
    dans la face superieure.
    - bombe obtenu par intersection avec un grand cylindre (fleche parametrable)
    - les rainures EPOUSENT le bombe : profondeur constante d'un bout a l'autre
    (une saignee droite serait profonde au centre et nulle aux extremites)
    - aretes laterales adoucies par minkowski
    - percages avec lamage, desactivables
    Claude-Session: https://c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
    [poignee-caisson.scad]
2026-09-13 feat(machine): integration Home Assistant de la VCore (carte + alimentation)
    - carte picture-elements : photo de l'imprimante avec etat, progression,
    temperatures, couche, ETA et boutons pause/reprise/annulation superposes
    (positions en pourcentage, a ajuster sur sa propre photo)
    - pilotage de l'alimentation par Moonraker [power] plutot que par un
    interrupteur HA nu : locked_while_printing empeche la coupure en pleine
    impression, et le bouton apparait aussi dans Mainsail
    - avertissement : le Raspberry Pi ne doit PAS etre sur la prise commutee
    (coupure a chaud = corruption de carte SD)
    - automatisation d'alerte sur erreur/shutdown Klipper avec photo webcam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
2026-09-13 feat(ha): carte RatRig au format du dashboard existant
    Refonte de la carte pour coller au style des autres (image en grand avec
    nom et etat en surimpression, puis tuiles et grille de boutons) au lieu du
    picture-elements qui jurait.
    - vue CAMERA LIVE en image principale plutot qu'une photo figee
    - tuiles colorees : progression, buse, plateau, couche, fin estimee
    - boutons pause / reprendre / annuler / arret d'urgence, avec confirmation
    sur les deux derniers
    - tuile d'alimentation (switch.ratrig_bureau)
    - cartes natives uniquement, aucune dependance HACS supplementaire
    Claude-Session: https://claude.ai/code/session_01MgZBhzqDaUsA1XaN7FJ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
2026-09-13 docs(ha): adresse reelle du Home Assistant (192.168.1.252) dans la config [power]
    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
2026-09-13 HA: carte RatRig calquée sur le format des autres appareils
    Ajoute un titre avec emoji au-dessus de l'image, comme les cartes
    Climatiseur Condor / Redkey R11 / Purificateur d'air de la section
    Appareils. Documente le remplacement du flux caméra par une photo
    figée pour ceux qui préfèrent.
    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
2026-09-13 HA: documenter la caméra MJPEG et confirmer le préfixe des entités
    Le préfixe 'ratrig' est vérifié dans Outils de développement (appareil
    Atelier > Ratrig) : toutes les tuiles remontent des valeurs réelles.
    L'intégration Moonraker ne crée aucune entité du domaine camera : ajoute
    le bloc mjpeg à declarer dans configuration.yaml, et la raison du retour
    en MJPEG (le camera-streamer WebRTC ne tenait pas, et HA ne consomme pas
    de WebRTC sans go2rtc plus une carte HACS).
    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
2026-09-13 HA: boutons sur une seule ligne (grille 4 colonnes)
    Ramene la hauteur de la carte RatRig a celle des autres appareils de la
    section, au lieu du double.
    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
2026-09-13 machine: ajouter crowsnest.conf (webcam)
    Config de reference, absente du depot jusqu'ici. Reconstituee depuis le
    log de la machine, avec quatre corrections :
    - device par chemin /dev/v4l/by-id stable plutot que /dev/video0
    - 1280x720 au lieu de 640x480 : la C310 fournit ce MJPG en materiel,
    le Pi ne fait que relayer
    - --format=MJPEG pour eviter que ustreamer compresse en logiciel depuis
    du YUYV, et --drop-same-frames=30 pour la vue a l'arret
    - log_level quiet + delete_log : le log grossissait sans limite
    Documente aussi le champ Service de Mainsail (Mjpegstreamer Adaptive),
    seule cause du flux noir quand crowsnest sert du MJPEG, et le bloc
    camera mjpeg a declarer dans Home Assistant.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
2026-09-13 machine: sortir les commentaires de fin de ligne dans crowsnest.conf
    crudini ne retire pas les commentaires places apres une valeur sur la
    meme ligne : log_level valait litteralement 'quiet # etait verbose...'.
    Les commentaires passent sur leur propre ligne.
    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
2026-09-13 machine: retablir les commentaires en fin de ligne dans crowsnest.conf
    Le commit precedent les avait deplaces en affirmant que crudini ne les
    gerait pas. C'est faux : le fichier livre par crowsnest lui-meme les
    utilise (# Valid Options are quiet/verbose/debug). Retour au format
    d'origine.
    Precise aussi que mode: ustreamer est la seule ligne modifiee par
    rapport a la version precedente du fichier, et que le chemin by-id et
    le 1280x720 avaient ete perdus lors du retour en MJPEG.
    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
2026-09-13 machine: repasser crowsnest en camera-streamer (WebRTC)
    camera-streamer sert le WebRTC et le MJPEG simultanement : Mainsail prend
    /webcam/webrtc, Home Assistant prend /webcam/?action=stream. Il n'y avait
    pas de choix a faire entre les deux, contrairement a ce que j'avais dit.
    Seul changement par rapport a la config qui tournait hier : max_fps passe
    de 30 a 15. En WebRTC camera-streamer reencode en H264 pour chaque client ;
    a 720p30 sur un Pi 4 le transcodage sature l'encodeur materiel, ce qui est
    la piste la plus probable pour l'arret du flux, et ce genre de decrochage
    ne laisse pas de trace dans crowsnest.log.
    Ajoute une procedure de diagnostic ordonnee si le flux retombe, et
    documente la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
2026-09-14 machine: trempe thermique avant le maillage dans START_PRINT
    M190 rend la main des que le thermistor atteint la consigne, alors qu'une
    plaque de 400x400 est encore chaude au centre et tiede sur les bords. Le
    maillage etait donc pris sur une plaque qui continuait de se deformer,
    d'ou des cartes qui varient d'une impression a l'autre.
    Ajoute un parametre SOAK (240 s par defaut) place apres G28 + Z_TILT, qui
    absorbent deja une a deux minutes. SOAK=0 pour les impressions a la
    chaine, ou le plateau est deja stabilise.
    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
    [printer.cfg]
2026-09-14 machine: ajouter axis_twist_compensation (sonde a 21,1 mm de la buse)
    La Cartographer est 21,1 mm derriere la buse. Tout basculement de la tete
    autour de X fait lire a la sonde une hauteur differente de celle que verra
    la buse, d'un montant 21,1 x tan(angle) : 0,5 degre donne 0,18 mm, soit
    toute l'amplitude du bed_mesh releve. Comme ce basculement varie avec la
    position, il produit exactement le degrade diagonal observe.
    x_offset vaut 0, donc le roulis ne contribue pas ; seul le basculement
    compte, mais amplifie par les 21,1 mm.
    horizontal_move_z force a 2 : la valeur par defaut de Klipper (5) met le
    coil en limite de sa plage 0,1-5 mm, comme pour bed_mesh.
    Bornes exprimees en position de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
    [printer.cfg]
2026-09-14 machine: corriger crowsnest.conf sur la base du fichier reel de la machine
    Deux defauts dans le fichier en service :
    1. device pointait sur video-index1. Une webcam UVC expose deux noeuds :
    index0 pour les images, index1 pour les metadonnees. Sur index1
    camera-streamer ouvre un peripherique valide dont aucune image ne sort,
    et le WebRTC reste en negociation sans jamais signaler d'erreur. Le log
    de crowsnest annoncait pourtant le bon noeud.
    2. 'vcgencmd get_throttled' avait ete colle sous v4l2ctl. C'est une
    commande de terminal ; la, elle serait passee a v4l2-ctl, et la ligne
    sans separateur pouvait faire echouer la lecture de la section.
    Aussi : enable_rtsp repasse a fal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
2026-09-15 machine: declarer le COB en neopixel WS2811 au lieu d'une sortie PWM
    Le ruban est un BTF-Lighting FCOB SPI RGB a IC WS2811 : le troisieme fil
    porte des donnees, pas un rapport cyclique. [output_pin cob_led] en PWM ne
    pouvait donc rien en faire.
    - [output_pin cob_led] -> [neopixel cob_led] sur PB10
    - color_order RGB, et non le GRB de chamber_leds : le WS2811 et le WS2812
    n'ont pas le meme ordre, s'y tromper inverse rouge et vert
    - chain_count a 20 en valeur de depart : en 24 V un IC commande un segment
    (souvent 6 LED), donc un segment = un trait de coupe, a compter sur la
    longueur reellement installee
    - _COB ecrit desormais du blanc a l'intensite demandee via SET_LED, ce qui
    reprodui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
    [leds.cfg, printer.cfg]
2026-09-15 machine: basculer le FCOB WS2811 sur PB0 et ajouter COB_TEST
    Le ruban est cable sur le connecteur Neopixel (PB0), 24 V et GND pris a
    l'alimentation. chamber_leds passe en commentaire : deux sections
    [neopixel] ne peuvent pas partager une broche, Klipper refuserait de
    demarrer.
    Pour que rien ne casse, _LED_VARS pointe variable_neopixel sur cob_led :
    tous les STATUS_* continuent de fonctionner, sur le nouveau ruban.
    variable_cob est vide et _COB teste ce cas avant d'agir, sinon il
    ecraserait en blanc la couleur que _LED_RGB vient de poser — l'orange de
    pause serait devenu du gris.
    Ajoute COB_TEST (rouge, vert, bleu, blanc) qui verifie d'un coup le
    cablage, le color_order et le chain_count,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
    [leds.cfg, printer.cfg]
2026-09-15 machine: script de bascule du COB sur PB0 sans toucher a SAVE_CONFIG
    printer.cfg de la machine contient le bloc SAVE_CONFIG (PID, modele
    Cartographer, Z offset, bed mesh) : le remplacer par la version du depot
    l'effacerait. Ce script fait donc une modification chirurgicale.
    Il remplace [output_pin cob_led] (PWM sur PB10) par [neopixel cob_led]
    sur PB0, commente [neopixel chamber_leds] qui ne peut pas partager la
    broche, sauvegarde l'original horodate, et verifie avant d'ecrire que le
    bloc SAVE_CONFIG est toujours la et qu'aucune section n'est en double.
    Idempotent : relance sans effet si le fichier est deja a jour.
    Claude-Session: http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
2026-09-15 machine: chain_count 47 et script relancable pour ajuster le ruban
    47 segments comptes sur le FCOB installe.
    patch_leds.py accepte desormais --chain, --order et --pin, et met a jour
    une section [neopixel cob_led] deja en place au lieu de ne rien faire :
    il reste donc utile apres COB_TEST, quand il faut corriger le color_order
    ou affiner le nombre de segments.
    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
    [printer.cfg]
2026-09-15 machine: ajouter [include leds.cfg], qui manquait
    leds.cfg etait present sur la machine mais jamais lu : printer.cfg ne
    l'incluait pas. Toutes ses macros — STATUS_*, COB_TEST, LUMIERE — etaient
    donc inexistantes pour Klipper, d'ou « Unknown command: COB_TEST ».
    patch_leds.py insere desormais l'inclusion apres le dernier [include] du
    fichier s'il ne la trouve pas.
    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
    [printer.cfg]
2026-09-15 machine: allumage automatique du ruban a l'impression
    STATUS_PRINTING au debut de START_PRINT, STATUS_DONE en fin d'END_PRINT.
    La lumiere s'allume donc des la chauffe, bien avant la premiere couche, et
    passe au vert une fois termine.
    Ce n'est pas cosmetique : la webcam filmait dans le noir, et le workflow n8n
    de detection d'anomalie analyse ces memes images — sans lumiere, le modele
    ne voit rien non plus.
    patch_leds.py insere les deux lignes, en reprenant l'indentation de l'ancre
    et sans rien faire si elles sont deja la. Correction au passage : l'ancre
    utilisait \\s qui englobe le saut de ligne, ce qui faisait atterrir
    STATUS_DONE apres une ligne vide.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
    [printer.cfg]
2026-09-15 machine: LED_ON/OFF/DIM ne nomment plus chamber_leds en dur
    _USER_START_PRINT_BEFORE_HOMING appelle LED_ON, qui faisait un SET_LED sur
    chamber_leds — ruban mis en pause. Klipper interrompait donc START_PRINT sur
    « The value 'chamber_leds' is not valid for LED », la chauffe n'avait jamais
    lieu, et le G-code suivant echouait sur « extruder not hot enough ». Les LED
    restaient blanches parce que STATUS_PRINTING etait deja passe.
    Les trois macros appellent desormais LUMIERE / LUMIERE_OFF / LUMIERE V=0.2,
    qui lisent le nom du ruban dans _LED_VARS : le nom n'existe plus qu'a un seul
    endroit.
    Le script applique la meme reecriture et refuse d'ecrire s'il reste un
    SET_LED actif pointant sur un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
    [printer.cfg]
2026-09-15 machine: une couleur par etape de START_PRINT
    STATUS_PRINTING etait appele en tete de START_PRINT : blanc plein fige pour
    toute la sequence, aucune couleur d'etape visible. Il repart juste avant la
    premiere couche, et chaque etape annonce la sienne — bleu a la chauffe, cyan
    au homing, violet au Z-tilt, vert d'eau au maillage.
    Les macros de chauffe posent desormais leur couleur IMMEDIATEMENT. M190 et
    M109 gardent le verrou du gestionnaire de commandes jusqu'a la consigne : la
    boucle de degrade ne peut pas s'executer pendant la chauffe, elle attend son
    tour. Sans cette couleur immediate, le ruban gardait celle d'avant — ce qui
    explique le blanc permanent observe.
    patch_leds.py insere les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
    [leds.cfg, printer.cfg]
2026-09-15 chore: ignorer les sauvegardes horodatees de patch_leds.py
    Le script ecrit un .cfg.bak-<date> a cote du fichier qu'il modifie. Quand on
    le lance sur machine/printer.cfg pour verifier son comportement, cette
    sauvegarde atterrit dans le depot sans avoir rien a y faire.
    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
2026-09-15 machine: animer le ruban avec klipper-led_effect
    Les macros d'etat posaient une couleur fixe. Elles lancent desormais une
    animation : comete bleue a la chauffe, balayage cyan au homing, comete
    violette au Z-tilt, balayage vert d'eau au maillage, respiration orange en
    pause, strobo rouge en erreur.
    led_effect anime en tache de fond a 24 images par seconde, independamment
    du gestionnaire de commandes. C'est ce qui permet a l'animation de tourner
    PENDANT M190 et M109, ce qu'une boucle delayed_gcode ne pouvait pas faire :
    ces commandes gardent le verrou jusqu'a la consigne.
    L'impression reste volontairement en blanc fixe. La webcam a besoin d'un
    eclairage constant : une lumiere qui varie fait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
    [led-effects.cfg, leds.cfg, printer.cfg]
2026-09-15 machine: couleur de chauffe pilotee par la temperature, animations plus rapides
    La couche "heater" de led_effect lit directement la temperature du chauffage
    nomme dans son champ "heater:" et fond la palette de la temperature minimale
    jusqu'a la consigne : vert a froid, orange a mi-chemin, rouge une fois la
    consigne atteinte. La couleur n'approxime plus la temperature, elle en decoule.
    Une comete blanche est posee au-dessus : la couche heater donne la couleur,
    la comete donne le mouvement.
    Deux animations distinctes, une par chauffage — ef_chauffe_plateau sur
    heater_bed, ef_chauffe_buse sur extruder — puisque le champ "heater:" se
    declare au niveau de la section.
    Vitesses relevees part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
    [led-effects.cfg, leds.cfg]
2026-09-15 machine: chauffe jaune-orange-rouge et sens alterne a chaque etape
    Palette de chauffe : jaune a froid, orange a mi-chemin, rouge une fois la
    consigne atteinte (etait vert-orange-rouge).
    Le sens de defilement alterne d'une etape a l'autre — une vitesse negative
    inverse la comete. Chauffe plateau vers la droite, homing vers la gauche,
    Z-tilt vers la droite, maillage vers la gauche, chauffe buse vers la droite.
    Le changement d'etape devient lisible meme quand les couleurs se ressemblent.
    Une animation lancee tourne jusqu'a ce qu'une autre la remplace : chaque
    etape garde donc la sienne jusqu'a la suivante, sans rien avoir a faire.
    Documente un repli si la couche heater n'est pas acceptee p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
    [led-effects.cfg]
2026-09-15 machine: fiabiliser la couche heater des animations de chauffe
    Symptome : plateau chaud, ruban qui semble clignoter en blanc. C'est la
    comete blanche visible sur un fond noir, la couche heater ne produisant
    rien.
    Deux causes traitees :
    - La palette heater comptait trois tons. Une palette a trois tons n'est pas
    garantie supportee par toutes les versions du module, et une palette
    refusee donne une couche noire. Deux tons suffisent : interpoler du jaune
    vers le rouge passe de lui-meme par l'orange.
    - La couche heater ne s'active que si le chauffage a une CONSIGNE. Un
    plateau qui refroidit apres une impression est a target=0 : pour
    led_effect il est eteint. C'est documente dans le f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
    [led-effects.cfg]
2026-09-15 machine: abandonner la couche heater au profit d'un degrade qui defile
    Symptome, sur le plateau comme sur la buse : ruban qui semble clignoter en
    blanc. C'est la comete blanche seule, visible sur le fond noir que rend une
    couche refusee par le module.
    La couche heater a ete tentee trois fois sans succes. Sa syntaxe varie selon
    les versions de klipper-led_effect et elle ne peut pas etre verifiee sans la
    machine ; une quatrieme tentative a l'aveugle ne se justifie pas.
    gradient etale la palette jaune / orange / rouge le long du ruban et la fait
    defiler. Les trois tons demandes sont la, l'animation est la, et la couche ne
    depend d'aucun capteur. On perd le lien avec la temperature reelle —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
    [led-effects.cfg]
2026-09-15 machine: chauffe en fondu de couleur, sans mouvement
    Demande : pour ef_chauffe_plateau et ef_chauffe_buse, uniquement le
    changement de couleur du jaune au rouge en passant par l'orange, fixe.
    linearfade fond la palette dans le temps, tout le ruban prenant la meme
    couleur au meme instant. La comete et le gradient qui defilait sont retires :
    il ne reste qu'une couche.
    Fondu complet en 12 s pour le plateau, 7 s pour la buse qui monte plus vite.
    Le cycle boucle et ne lit pas la temperature — c'est documente dans le
    fichier, avec la ligne heater exacte pour qui voudrait y revenir.
    Claude-Session: https://claude.ai/code/session_01MgZBhzqDa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
    [led-effects.cfg]
2026-09-15 machine: blanc d'impression ecrit directement, palettes a une couleur doublees
    Symptome : pendant l'impression, le premier segment restait rouge et le reste
    blanc. Un SET_LED direct sur le meme ruban l'allume correctement — le
    cablage et le niveau logique sont donc hors de cause, c'est led_effect qui
    laisse ce premier segment sur une teinte parasite avec une palette a une
    seule couleur.
    STATUS_PRINTING n'appelle plus d'animation : STOP_LED_EFFECTS puis un
    _LED_RGB blanc plein. C'est de toute facon ce qu'on veut pendant une
    impression — aucune animation, un eclairage constant pour la webcam et pour
    le workflow n8n — et ca utilise le chemin dont on vient de verifier qu'il
    fonctionne.
    L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
    [led-effects.cfg, leds.cfg]
2026-09-15 machine: ef_mesh en orange au lieu du vert d'eau
    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
    [led-effects.cfg, leds.cfg]
2026-09-15 machine: ralentir les animations d'environ moitie
    Vitesses jugees trop rapides a l'usage. Homing -3,5 -> -1,6, Z-tilt 2,2 ->
    1,0, maillage -2,8 -> -1,3, strobo d'erreur 2,5 -> 1,4, respiration de pause
    1,5 -> 3 (c'est une duree, donc un nombre plus grand ralentit).
    Precise dans l'en-tete que breathing et linearfade prennent une duree la ou
    comet, chase et strobe prennent une vitesse — les deux se reglent en sens
    inverse, ce qui n'est pas evident.
    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
    [led-effects.cfg]
2026-09-15 machine: adoucir le maillage — comete lente, orange plus profond
    Le chase decoupait le ruban en segments qui s'allument et s'eteignent
    franchement : effet stroboscopique agressif, que ralentir ne suffit pas a
    corriger. Une comete a longue traine a un degrade sur toute sa longueur,
    donc aucune transition brutale.
    Vitesse -1,3 -> -0,5, traine 4 -> 12 segments sur les 47.
    Couleur : vert abaisse de 0,45 a 0,28, ce qui deplace la teinte du jaune
    orange vers un orange franc.
    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
    [led-effects.cfg]
2026-10-06 machine: chamber_fan sur PE5 (FAN1), pas PA8
    Le ventilateur de caisson est physiquement branche sur FAN1 alors que la
    config nommait PA8, soit FAN0 — un connecteur vide. Klipper commandait donc
    dans le vide et rien ne tournait.
    Note aussi que ce ventilateur est en 12 V : le cavalier de tension de FAN1
    doit etre regle en consequence, sous peine de le griller.
    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
    [printer.cfg]
2026-10-06 machine: activer le capteur de caisson, aligne sur la machine
    Le bloc etait encore commente dans le depot alors qu'il est actif sur la
    machine. Documente au passage que le thermistor doit pendre dans l'air
    libre : pose dans le bac electronique ou dans un courant d'air, il mesure
    l'ambiant et non le caisson.
    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
    [printer.cfg]
2026-10-06 machine: extraction du caisson pilotable depuis le slicer
    _USER_START_PRINT_BEFORE_HOMING lancait CHAMBER_FAN_ON SPEED=0.5 en dur, a
    chaque impression. C'est bon pour le PLA et le PETG, mais c'est l'inverse de
    ce qu'il faut en ABS ou ASA : on evacue la chaleur du caisson, celle-la meme
    qui empeche le retrait et le decollement. Ca explique aussi un caisson qui
    plafonne a 35 degres.
    START_PRINT accepte desormais CHAMBER_FAN (0.5 par defaut) et depose la
    valeur dans _PRINT_VARS, que le crochet relit — les crochets _USER_* ne
    recoivent pas les parametres de START_PRINT, d'ou ce porte-variable.
    START_PRINT ... CHAMBER_FAN=0 ABS / ASA
    START_PRINT ... CHAMBER_FAN=0.5 PLA / PETG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
    [printer.cfg]
2026-10-12 machine: config du nettoyeur de buse a servo (modele WiggyWooSaa)
    Brosse metallique deployee par servo, montee sur profile 3030. Remplace
    nozzle-wiper.cfg, qui decrivait une brosse fixe — les deux ne doivent pas
    etre inclus ensemble.
    Servo sur PG11, verifie libre sur cette machine. Angles et largeurs
    d'impulsion repris de la documentation du modele.
    Trois ajouts par rapport au fichier de l'auteur :
    - Le degagement en Z est conditionnel et se fait AVANT le deploiement : la
    brosse sort dans la zone de travail.
    - La tete s'ecarte avant la retraction, sinon la brosse croise la buse en
    remontant.
    - Un delayed_gcode retracte la brosse au demarrage : si Klipper a redemarre
    brosse deploye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
2026-10-13 machine: balayage de la brosse en X au lieu de Y
    Le support est monte de sorte que la buse doit parcourir la brosse en X,
    pas en Y comme dans la documentation du modele. Les variables deviennent
    x_min / x_max pour la course et y_wipe pour la position fixe, et la boucle
    d'essuyage comme le degagement avant retraction suivent.
    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
2026-10-13 machine: se degager avant de deployer la brosse horizontale
    La brosse se deploie a l'horizontale : en sortant comme en rentrant, elle
    traverse une zone du plan XY. Le deploiement se faisait avec la tete la ou
    elle se trouvait, ce qui pouvait la faire percuter — ou plier le bras du
    servo.
    La tete se range desormais sur un point x_safe / y_safe choisi hors de
    l'arc, avant chaque mouvement du servo, a l'aller comme au retour.
    Precise aussi que le G1 Z ecarte le PLATEAU et non la buse, le portique
    etant fixe en Z sur une VCore, et que la condition evite de remonter le
    plateau en pleine impression.
    Claude-Session: https://claude.ai/code/s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
2026-10-13 machine: balayage en Y, coordonnees relevees sur la machine
    Les mesures donnent X fixe a 10 et Y variant de 254 a 388 : la brosse est
    posee le long du montant gauche et le balayage se fait bien en Y, comme
    dans la documentation du modele. « Horizontal » designait la pose de la
    brosse, pas l'axe du mouvement.
    x_wipe 10, y_min 254, y_max 388 — 134 mm de course. Le point de degagement
    x_safe / y_safe, introduit pour la brosse a deploiement horizontal, est
    conserve : il reste necessaire quel que soit l'axe de balayage.
    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
2026-10-13 machine: z_safe a 50 mm, le plateau doit passer sous la brosse
    z_safe valait 10. La brosse essuie la buse, donc elle se trouve a hauteur de
    buse : descendre le plateau de 10 mm ne degageait que le vide sous la buse,
    pas l'epaisseur du bras qui vient se deployer juste au-dessus du plateau.
    50 mm comme point de depart, avec la methode pour trouver la vraie valeur :
    brosse deployee, remonter le plateau par pas de 5 mm jusqu'a friser le bras,
    puis ajouter 10 mm de marge.
    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
2026-10-13 machine: z_safe a 80 mm, valeur relevee sur la machine
    En deca, le plateau est encore dans le passage du bras au deploiement.
    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
2026-10-13 machine: essuyage en fin d'impression, chauffe rendue optionnelle
    NOZZLE_CLEAN executait M104/M109 meme avec TEMP=0, donc M109 S0 — Klipper
    attendait le refroidissement. Le test a froid aurait bloque. La chauffe est
    desormais conditionnelle.
    NOZZLE_CLEAN TEMP=0 ajoute a END_PRINT, apres le degagement en Z et avant
    TURN_OFF_HEATERS : la buse est encore a temperature d'impression, le residu
    est mou, et rien n'attend. Apres TURN_OFF_HEATERS il durcirait, rayerait la
    brosse sans partir.
    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
2026-10-22 repo: l'imprimante passe de 192.168.1.41 a 192.168.1.40
    L'adresse de la machine a change et le .41 est desormais occupe par un
    autre appareil du reseau — confirme par le cache ARP, qui ne montre la MAC
    dc:a6:32:14:b1:95 que sur le .40, et par la liste des appareils de la box.
    Ca explique plusieurs symptomes a la fois : les deconnexions, le workflow
    n8n qui ne joignait plus Moonraker, et l'image cassee dans la carte Home
    Assistant.
    Sept fichiers mis a jour : les trois URL du workflow n8n, le bloc camera de
    Home Assistant, la documentation crowsnest et n8n, et les trois references
    de l'application.
    Claude-Session: https://claude.ai/cod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
2026-10-22 machine: LED RGB de buse, suivant les etapes et attenuee en impression
    Nouvelle [neopixel buse_led] sur toolhead:PD3 — seule broche libre de
    l'EBB42, et son port RGB. A confirmer, ainsi que chain_count.
    Les dix animations pilotent desormais les DEUX rubans : led_effect accepte
    plusieurs groupes de LED dans un meme effet, la buse suit donc le caisson
    sans une seule ligne de macro supplementaire.
    Palette de chauffe enrichie : blanc, cyan, vert, jaune, orange, rouge. Le
    fondu traverse tout le spectre du froid au chaud, au lieu des trois tons
    precedents.
    L'impression est le seul cas traite a part, et c'est volontaire : le
    caisson passe en blanc plein, la buse a 0,35. A pleine puissance et a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
2026-10-22 machine: jeu d'effets distinct pour la LED de buse, blanc a 0,45
    La buse partageait les effets du caisson. Elle a desormais les siens.
    Contrainte technique assumee : avec une seule LED, aucun effet SPATIAL
    n'est visible — comete, balayage et barre de progression supposent
    plusieurs LED en ligne. Les effets de buse sont donc temporels : fondu
    pour la chauffe, clignotement au homing et en pause, respiration au
    Z-tilt, au maillage et en fin, strobo en erreur. C'est cette contrainte
    qui les rend naturellement differents de ceux du caisson.
    Chaque STATUS_* lance les deux effets. REPLACE=1 ne coupe que ceux
    partageant les memes LED, les deux jeux coexistent donc sans se gener.
    Blanc d'impress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
2026-10-22 machine: adoucir les effets du caisson, supprimer tout scintillement
    Les animations restaient percues comme stroboscopiques. Trois leviers
    actionnes ensemble plutot qu'un seul :
    - chase remplace par comet au homing. Le chase decoupe le ruban en segments
    qui s'allument et s'eteignent net ; la comete etale un degrade sur toute
    sa traine, sans transition brutale.
    - Traines allongees : 16 a 18 segments sur les 47, contre 3 a 12.
    - Vitesses reduites : homing -1,6 -> -0,55, Z-tilt 1,0 -> 0,45, maillage
    -0,5 -> -0,4.
    - Fonds releves. C'est le levier le plus efficace et le moins evident : la
    gene vient autant du contraste que de la vitesse. Un point vif sur un
    ruban noir scintille ; sur u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
2026-10-22 machine: LED de buse a 0,60 en impression
    Troisieme palier sur demande : 0,35 puis 0,45, desormais 0,60.
    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
2026-10-22 machine: macro TEST_VENTILO_BUSE
    Un [heater_fan] ne se commande pas a la main — Klipper refuse de l'eteindre
    tant que la buse est chaude, et SET_FAN_SPEED renvoie une erreur dessus. Le
    seul test possible est de chauffer au-dessus du seuil et de le laisser
    demarrer seul.
    La macro lit heater_temp dans la configuration plutot que de le figer, puis
    chauffe 10 degres au-dessus, attend, laisse 10 secondes pour ecouter, et
    coupe.
    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
2026-11-04 machine: limite de course en Y apres changement de la vis Z arriere
    La vis Z arriere a ete remplacee et depasse davantage : la tete cogne avant
    d'atteindre le bout de sa course en Y. Le homing passe toujours — c'est
    apres le maillage, au parking de chauffe a Y=395, que ca butait.
    La limite est centralisee dans _PRINT_VARS.y_max_sur plutot que repetee :
    les parkings de START_PRINT et END_PRINT s'y referent, et le balayage de la
    brosse y est ramene (388 -> 355). Un seul chiffre a ajuster apres mesure.
    355 est une valeur prudente de depart. La methode de mesure est documentee
    dans la variable elle-meme.
    z_tilt et bed_mesh n'ont pas besoin d'etre touches : la sonde etant 21,1 mm
    devant la b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
2026-11-04 machine: macro CHAUFFE_CAISSON pour l'ABS et l'ASA
    Pas de chauffage de caisson dedie : un plateau de 1400 W dans un volume
    ferme suffit. Ce qui manque d'habitude n'est pas la puissance mais le temps
    et l'etancheite.
    La macro coupe l'extraction, chauffe le plateau et attend la temperature
    REELLE du caisson via TEMPERATURE_WAIT sur le capteur existant, plutot
    qu'une duree fixe : selon la temperature de la piece, la montee prend de dix
    minutes a une demi-heure. Elle passe son chemin si la cible est deja
    atteinte.
    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
2026-11-04 machine: macro CAISSON_OFF, pendant de CHAUFFE_CAISSON
    Coupe le plateau et relance l'extraction a fond. Les deux macros ont une
    description, donc Mainsail les affiche avec leur texte d'aide dans le
    panneau Macros.
    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
2026-11-05 machine: repasser en ustreamer — le WebRTC fait planter le noyau
    Trace du 4 novembre, en pleine impression :
    WARNING ... __vb2_queue_cancel [videobuf2_common]
    bcm2835_codec_release [bcm2835_codec]
    videobuf2_common: driver bug: stop_streaming operation is
    leaving buf ... in active state
    bcm2835-codec: Timeout waiting for buffers to be returned
    CPU: 0 PID: 2035 Comm: SCTP timer
    « SCTP timer » est le fil des canaux de donnees WebRTC : le processus en
    cause est camera-streamer, au moment ou il libere l'encodeur H264 materiel
    du Raspberry. Le pilote bcm2835_codec laisse un tampon en etat actif et le
    noyau part en Oops. Bug du pilote video du Pi, p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
